wulffern/lelo_temp_sky130a/design/LELO_TEMP_SKY130A/LELOTEMP_CMPR.md

A two-stage OTA used as comparator. Uses a 1U bias current from the bandgap.

It also owns the ramp node housekeeping: an NMOS gated by RST discharges the
integrating node between cycles, and one gated by PWRUP\_N holds it down in
power down.
