wulffern/lelo_temp_sky130a/design/LELO_TEMP_SKY130A/LELOTEMP_CMP.md

A two-stage OTA used as comparator. Uses a 1U bias current from the bandgap
