wulffern/lelo_temp_sky130a/design/LELO_TEMP_SKY130A/LELO_TEMP_routing.png

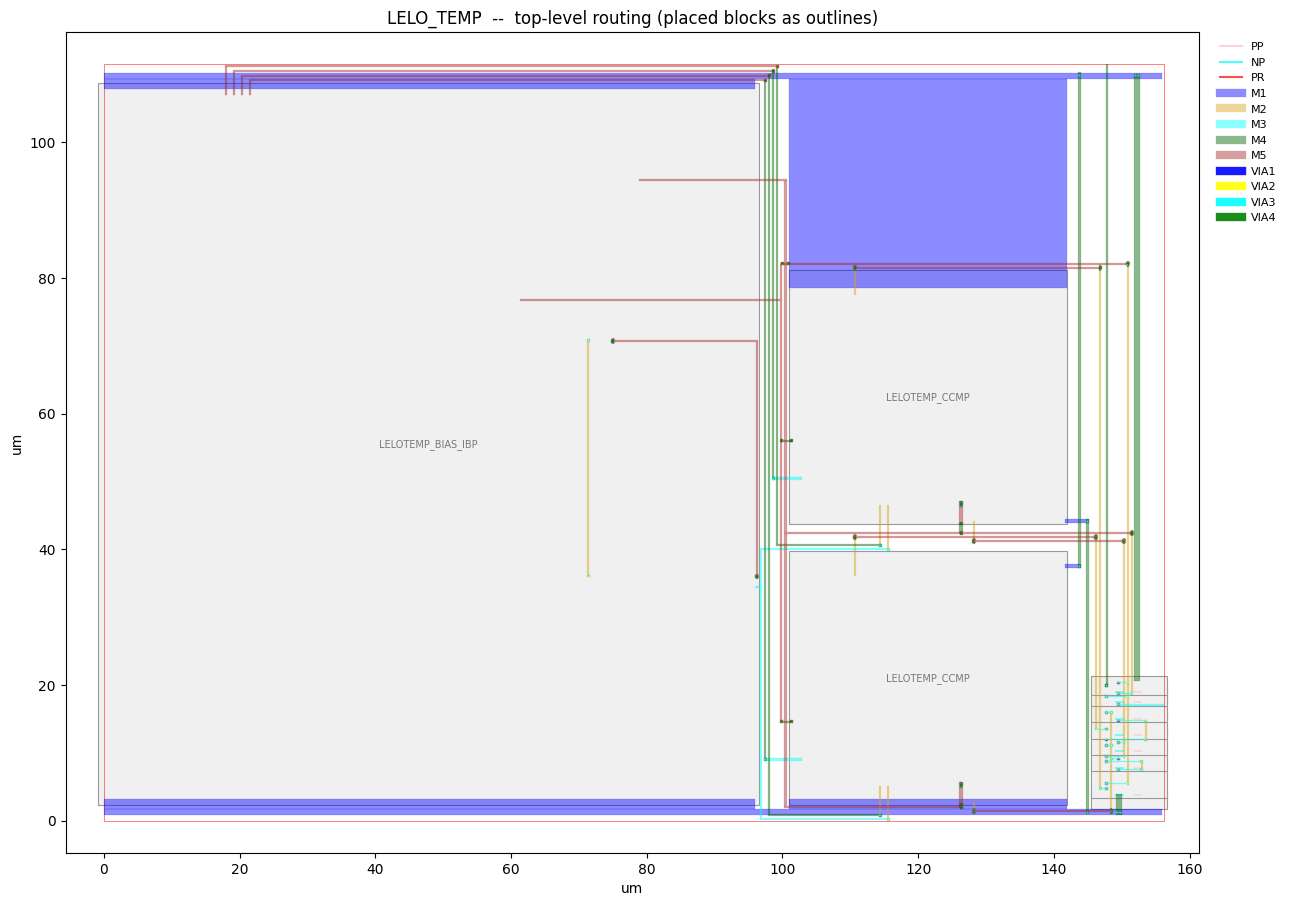
design/LELO_TEMP_SKY130A/LELO_TEMP_routing.png
