wulffern/lelo_temp_sky130a/design/LELO_TEMP_SKY130A/LELO_TEMP.v

//====================================================================
//        Copyright (c) 2025 Carsten Wulff Software, Norway
// ===================================================================
// Created       : wulff at 2025-11-23
// ===================================================================
//  The MIT License (MIT)
//
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
//====================================================================
`timescale 1 ns / 1 ps
`default_nettype none

module LELO_TEMP(
                 input wire  PWRUP_1V8,
                 input wire  VDD_1V8,
                 input wire  VSS,
                 output wire OSC_TEMP_1V8
`ifdef ANA_TYPE_REAL
                 ,input real temperature
`endif
                 );
   //- Define the clock
   logic                     oclk = 0;

   assign OSC_TEMP_1V8 = PWRUP_1V8 &oclk;

   //- Pre-calcualted k/q
   real                      k_q = 8.617333262145179e-05;
   real                      deltaV,id,vd;

   //- Resistance
   real                      rd =  7.535e3*(8+4);
   real                      r_per_K = 36;
   real                      res_temp = rd;

   //- Capacitor to charge
   real                      cap = 53e-15*5 + 19e-15;
   real                      cmp_delay = 1.5e-9;


   //- Delta time for output clock
   real                      dt = 1000;
   real                      to_ns = 1e9;


   real                      ell = 2.35;
   real                      t_kelvin;
   real                      v_bandgap = 1.12;



   //- Generate the output clock
   always begin

      t_kelvin = 273.15 + temperature;
      //- Calculate diode voltage
      //- https://analogicus.com/aic2025/2024/10/25/Diodes.html
      vd = k_q*(t_kelvin)*(ell - 3 *$ln(t_kelvin)) + v_bandgap;

      //- Calculate the delta voltage across the resistance
      deltaV = k_q*(t_kelvin)*$ln(64);

      //Model temperture dependent resistance
      res_temp = rd + r_per_K*(t_kelvin - 300);

      //- Calculate the time to reach the diode voltage
      id = deltaV/res_temp;

      //- dt
      dt = cap*vd/id*to_ns + cmp_delay;

      #(dt) oclk = ~oclk;
   end

endmodule // LELO_TEMP_ANA
