wulffern/lelo_temp_sky130a/(commit log)

2025-11-30 Redesigned, and got chat's help to design the controller correctly. Now the analog is enabled for 1 32kiHz period, while the digital takes a bit longer
    [LELO_TEMP.v, tb.py, tb.v, temp_osc_controller.v]
2025-12-01 added schematic of the oscillator
    [LELOTEMP_BIAS_IBP.sch, LELOTEMP_CMP.sch, LELOTEMP_OTA.sch, LELO_TEMP.sch]
2025-12-11 Added docs
    [LELOTEMP_BIAS_IBP.sch]
2025-12-11 Still trouble at Kff
    [LELO_TEMP.sch]
2025-12-13 Spead up of comparators a bit
    [LELOTEMP_CMP.sch, LELO_TEMP.sch, TB_LELO_TEMP.sch]
2025-12-13 Reduced OTA current a bit
    [LELOTEMP_BIAS_IBP.sch, LELOTEMP_OTA.sch, LELO_TEMP.sch, TB_LELO_TEMP.sch]
2025-12-26 Updated model of verilog to match actual implementation
    [TB_LELO_TEMP.sch]
2026-01-23 testing ntnu github
    [TB_LELO_TEMP.sch]
2026-02-08 duplicate osc ports
    [LELO_TEMP.sch]
2026-02-08 Made NMOS input OTA
    [LELOTEMP_BIAS_IBP.sch, LELOTEMP_OTAN.sch, TB_LELOTEMP_BIAS_IBP_LSTB.sch, TB_LELO_TEMP.sch]
2026-02-08 Fixed NMOS ota (probably
    [LELOTEMP_BIAS_IBP.sch, LELOTEMP_OTAN.sch, TB_LELOTEMP_BIAS_IBP_LSTB.sch]
2026-02-08 Fixed startup
    [LELOTEMP_OTAN.sch, TB_LELO_TEMP.sch]
2026-03-01 tried to make it better
    [LELOTEMP_BIAS_IBP.sch, LELOTEMP_CMP.sch, LELOTEMP_OTAN.sch, LELO_TEMP.sch, TB_LELO_TEMP.sch, res_tempco.sch]
2026-04-05 added layouts
    [LELOTEMP_CMP.sch]
2026-04-05 One step further
    [LELOTEMP_CMP.sch]
2026-04-06 Added layout of comparator
    [LELOTEMP_CMP.sch]
2026-05-02 split up the OTA into multiple blocks to make layout easier
    [LELOTEMP_CASCBIAS.sch, LELOTEMP_CCMP.sch, LELOTEMP_CMP.sch, LELOTEMP_OTACMN.sch, LELOTEMP_OTAN.sch, LELOTEMP_START.sch, TB_LELOTEMP_BIAS_IBP_LSTB.sch]
2026-05-03 Fixed placement for start
    [LELOTEMP_START.py]
2026-05-03 fixed VBN
    [LELOTEMP_START.sch]
2026-05-03 LVS/DRC clean START
    [LELOTEMP_START.sch]
2026-05-03 Started CASCBIAS
    [LELOTEMP_CASCBIAS.sch]
2026-08-04 Drop the accessLayer argument from the pycells
    cicpy removed accessLayer from addOrthogonalConnectivityRoute, so every call
    that still passed it fails with
    TypeError: addOrthogonalConnectivityRoute() got an unexpected keyword
    argument 'accessLayer'
    The cicpy sch2mag test clones this repository and runs LELOTEMP_CMP through it,
    so cicpy CI has been failing on this since the argument went away. Pin geometry
    now comes from the port's own layer and needs no hint.
    Two unrelated adjustments made while getting these cells to route are included:
    LELOTEMP_CMP moves the PWRUP_N_1V8 edge port to "l" with a "-|--" route, and
    LELOTEMP_START widens the VCP ring spacing from 3 to 4.
    Verified with t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
    [LELOTEMP_CCMP.py, LELOTEMP_CMP.py, LELOTEMP_START.py]
2026-08-05 Back to the pmos input OTA, with startup and a packed DRC clean placement
    The bias loop goes back to LELOTEMP_OTA, the pmos input pair. The OTA
    input sits at a diode voltage, 0.45 to 0.8 V over temperature, which the
    nmos input version runs out of at the hot end on 1.8 V. The two symbols
    have identical pins, so the swap is one line of LELOTEMP_BIAS_IBP.
    Startup: two diode connected pmos in series from VDD into VD1. With no
    current VD1 sits near VSS, the stack sees the full supply and injects
    into the diode branch. Once the loop runs VD1 rises, VDD-VD1 falls below
    two gate source drops, and the stack turns itself off. Weakest device in
    the library, JNWATR_PCH_2C5F0, so it loads the loop as l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
    [LELOTEMP_BIAS_IBP.sch, LELOTEMP_OTA.sch]
2026-08-05 Mirror the matched halves and let them abut
    The right half of the input pair and of the matched loads is mirrored
    with the new StackGroup.mirror(), so each pair shares its seam with
    mirror symmetric edge geometry and abuts at zero gap where identical
    columns needed 2 um to stay DRC clean. DRC stays at zero and the cell
    shrinks from 9048x11120 to 8648x11120.
    The regenerated views also pick up the cicpy strap fix: the dummy straps
    now sit on the fillers they cover instead of floating outside the cell,
    which the previously committed mag carried without DRC noticing.
    [LELOTEMP_OTA.py]
2026-08-05 OTA: the ladder short was a power strap, not the stack pitch
    net2..net6 came out shorted to VDD_1V8 with no route attributed, so the
    placement itself looked wrong and the ladder stack had been opened up to
    try to stop the cells merging. That was never it. xbs6 is the only ladder
    device with a VDD source pin, and addPowerConnection straps such a pin
    straight up to the ring: from the bottom of the column that strap ran over
    the source pin of every other ladder device. Stacking the chain the other
    way round, VDD end at the top, makes the strap one cell long. The opened
    pitch is gone with it and the placement is back to abutted.
    With that clear the placement is 0 DRC and 0 shorts, and routing s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
    [LELOTEMP_OTA.py]
2026-08-05 LELOTEMP_OTAR: the OTA on the rey transistors, same device sizes
    Sizes first, since a name for name swap does not preserve them. Every REYATR
    transistor was 12.5% wider than the JNW cell of the same name and no contact
    count landed on the JNW numbers, because the contact pitch itself was 0.36 um
    against 0.32. Fixed in rey_atr rather than worked around here, so NCH_4C5F0,
    PCH_12C5F0, PCH_4C1F2, LVT_PCH_12C5F0 and the RPPO8 unit now match l, w and
    nf exactly. The netlist of OTAR is identical to OTA: same instances, same
    nets, same connectivity, different library.
    Placement is 0 shorts and 0 DRC, but not by copying LELOTEMP_OTA.py wholesale.
    The mirror calls had to go. Mirroring a matched half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
    [LELOTEMP_OTAR.sch]
2026-08-05 OTAR: power through the guard ring, no rail up the column
    Rings on M1, sources tied to their own guard at their own row, one strap per
    column off the body pin out to the ring. M2 upward is now entirely free for
    signals.
    This drops the workaround the strap version needed. REYATR's S and D pins
    overlap in x, so a rail leaving a source ran over its own device's drain, and
    net2 shorted to VDD under every routing option until the VDD strap was pushed
    to the far edge of the pin. A supply that does not travel cannot do that, and
    the alignment argument is gone with it.
    One device is held out: xbs6, the single VDD source in the ladder column,
    whose jog to the guard crosses VCP. 1 short with it in,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
    [LELOTEMP_OTAR.py]
2026-08-06 OTAR: five nets routed, 13 opens down to 8
    Working the plan's loop, one route at a time, keeping what held.
    VIN and VIP first, because every pin of each sits inside its own input
    column: a single vertical run each, neither leaves its stack. Closed
    both.
    VS next, the tail node, which is the source of every input device in
    both columns plus the top of the degeneration resistor down in the
    nmos row. A vertical in each column collapsed eleven components to
    three, and one orthogonal M4/M3 route joined those three across the
    channel and down to the resistor. Closed.
    VD1 and VD2 are the drain pair, each staying in its own lane. They
    close, but they cost: DRC goes from 4 errors to 36, all met2.2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
    [LELOTEMP_OTAR.py]
2026-08-06 OTAR: net1 and PWRUP_1V8 routed, 8 opens down to 6
    Two more nets closed, neither costing a DRC error: net1, the two pins
    between the resistor bottom and the powerdown pull above it, and
    PWRUP_1V8, three gates that all sit in the bias column and need one
    vertical.
    Three that were tried and taken back out, with what they hit:
    VO Its bar reaches from the bias column to the mirror drain
    below, and on every track and side tried, two of each,
    its trunk lands on VIN's in the input column. Shorts
    VD2, VIN and VO together.
    PWRUP_N_1V8 One gate in the bias column, three along the nmos row. A
    horizontal along the nmos row shor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
    [LELOTEMP_OTAR.py]
2026-08-06 OTAR: VCP gets a ring, and the plan's ring section is corrected
    The ring works. My first reading of it did not, and the plan said so
    wrongly, so this replaces that section with what actually holds.
    addRouteConnection was called with an empty includeInstances, which
    gives every pin on the net its own run to the rail, dummy fill included.
    LELOTEMP_START in this same library has always passed the filters and is
    the model. The rail also belongs on the side the pins are already on:
    VCP's groups end at the right of both rows, so the left rail I tried
    first meant crossing the cell.
    The third thing was real: ignoreBoundaryRouting has to be set or the
    ring joins the bounding box and drags the cell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
    [LELOTEMP_OTAR.py]
2026-08-06 OTAR: take the degeneration resistor from rey_tr
    xd2 was REYATR_RPPO8_TOP; it is REYTR_RPPO8 now. Same three pins in the
    same order, P N B, so the swap is the symbol reference and nothing else.
    rey_tr_sky130a joins config.yaml and design/REY_TR_SKY130A is symlinked
    the way the other libraries are.
    0 shorts, 6 opens, 36 DRC, all unchanged across the swap.
    Claude-Session: https://claude.ai/code/session_011UZw6MEnHap4TKj3arkbFP
    [LELOTEMP_OTAR.sch]
2026-08-06 OTAR: VO closed on M2, 6 opens down to 5
    REY_ATR leaves M2 free, which is the layer VO needed. It had failed on
    M3 and M4 because its trunk landed on VIN's in the input column; on M2
    the trunk is clear and only the horizontal had to move, from M3 to M5,
    to clear VD2's channel bar. M2 vertical, M5 horizontal, track6.
    The cost is DRC 36 to 60, all spacing between the new M5 bars and what
    is already in the channel. Four tracks were tried, two of them short,
    and 60 is the floor among the ones that hold.
    0 shorts, 5 opens. Left: VD3, VBP, VCP, PWRUP_N_1V8, and VDD_1V8 at
    xbs6.
    Claude-Session: https://claude.ai/code/session_011U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
    [LELOTEMP_OTAR.py]
2026-08-06 Revert VO: M5 is reserved for power
    The only form of VO that held used M5 for its horizontal, and M5 is the
    power layer. Backed out; VO is open again. 0 shorts, 6 opens, 36 DRC.
    Within M2, M3 and M4 there is no form of VO that both closes and stays
    clean: M3 and M4 put its trunk on VIN's in the input column, M2 clears
    the trunk but then the horizontal has to cross VD2's channel bar and
    only M5 was high enough to do it.
    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
    [LELOTEMP_OTAR.py]
2026-08-07 OTAR: VO crosses in the channel, 6 opens down to 5
    The placement opens an 84 um channel between the rows and nothing ever
    used it: cicpy tracks reports 21 M3 tracks there and 21 free, while
    every horizontal bar in the cell fights the others inside the device
    rows. That is where the evening went.
    afterPlace now registers the gap as a named channel, and each column as
    a vertical one, so routes can aim at them by track index rather than by
    coordinate and the cell still moves between technologies. VO takes
    channel track 5 and column track 8 of the b input lane.
    0 shorts, 5 opens, DRC unchanged at 36. Left: VD3, VBP, VCP,
    PWRUP_N_1V8, VDD_1V8 at xbs6.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
    [LELOTEMP_OTAR.py]
2026-08-07 OTAR: routes torn up, rebuilt from M1 upward
    The old routing put every net on M3/M4 from the start, which left the
    crossing nets and the column local ones fighting for the same two
    layers. It sat at one short, six opens and 51 DRC errors, with each
    guess costing a regeneration.
    Rebuilt in order of reach instead:
    inside one device the cell does it. REYATR now carries a diode
    connected twin tied with one column of M1, and
    cicpy substitutes it from the netlist
    inside one column M1 rails, drain on the right edge of its pin and
    gate on the left, so the two do not share metal
    between columns M2
    across the cell M3/M4,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
    [LELOTEMP_OTAR.py]
2026-08-07 OTAR: 12C is gone from the library, the pmos devices are 11C
    rey_atr's ceiling is 11C now, so the 24 devices that were 12C move.
    Note this changes them electrically: W drops 8%, and it buys nothing
    here. The pmos columns narrow from 8.32 to 8.00 um each but the cell
    does not, because the resistor already set the width --
    pmos row ends 30.24 um
    nmos transistors end 19.76 um
    REYTR_RPPO8 spans 21.76 .. 35.08 um
    Area is 2336 um2 either way, DRC clean, 0 shorts, 12 opens unchanged.
    If the 8% matters for this circuit, the fix is the schematic's device
    count, not the library.
    Claude-Session: https://claude.ai/code/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
    [LELOTEMP_OTAR.sch]
2026-08-07 Added OTAR symbol and fixed IBP instanciation
    [LELOTEMP_BIAS_IBP.sch]
2026-08-07 OTAR: REYTR_RPPO8 is gone, one REYATR_RPPO4 in its place
    A one for one swap so the cell builds, and it is NOT the same
    resistance. The old part was 8 units of l=7.36; the new one is 4 units
    of l=7.2, so R is 49% of what it was. Two RPPO4 in series would be 98%
    and is what this wants, but it needs a second instance and a rewire in
    the schematic rather than a symbol swap, and the space between the
    existing net1 wire and the VDD rail is 50 units where a resistor is 80.
    Area 2848 -> 2195 um2 across today, the last 141 of it from the
    narrower resistor. DRC clean, 0 shorts, 12 opens unchanged.
    Claude-Session: https://claude.ai/code/session_01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
    [LELOTEMP_OTAR.sch]
2026-08-07 OTAR: regenerate on the rebased symbol
    Rebuilt after rebasing onto the new OTAR symbol and the rey library
    link. DRC clean, 0 shorts, 12 opens, all unchanged.
    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
    [LELOTEMP_CASCBIAS.sch]
2026-08-07 Back out the files swept into the previous commit
    A rebase autostash left every pre-existing working tree change staged,
    and the OTAR commit took them with it: CASCBIAS, CCMP, CMP, START, two
    sim READMEs, three plots and .magicrc. None are mine, and all were
    deliberately left uncommitted all session because I cannot attribute
    them.
    Restored to their committed state here. The content is not lost -- it
    is in 6f30848 -- and the working tree keeps it as an uncommitted change
    again, which is where it was.
    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
    [LELOTEMP_CASCBIAS.sch]
2026-08-07 Fixed res in OTAR
    [LELOTEMP_BIAS_IBP.sch, LELOTEMP_OTAR.sch]
2026-08-07 OTAR placement follows your schematic changes
    The bus widths moved and the pycell was matching hard coded ranges:
    xbl1<[0-3]> against a pair that is now 6 a side, xbl0 against a group
    renamed xbl2, xnd1<[0-3]> against loads that are now 3. Devices past
    the range fell into no stack at all -- they still place, just nowhere
    anyone asked. Matching <\d+> instead, so the next width change does
    not need this file.
    Three things the three-deep resistor broke, all measured:
    the column is 48 um tall against an nmos row of 24.8, so the top cell
    climbed out and landed inside the bias column at x 217600 -- every
    rpm.3, rpm.6 and rpm.7 in the cell, DRC 0 -> 111. It has its own
    column right of bot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
    [LELOTEMP_OTAR.py]
2026-08-07 Drop the branch gap between the mirror and the load columns
    n_load_a and n_load_b have always abutted, and their guard rings
    overlap 0.96 um like any two transistor columns. Only n_mirr had
    space=branch_gap, on the strength of a comment claiming an abutted nmos
    boundary violates licon spacing across the seam -- which the other
    boundary in the same row disproves. Measured: abutted, DRC stays clean
    and shorts stay at 0.
    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
    [LELOTEMP_OTAR.py]
2026-08-07 feat(otar): degeneration resistor as a horizontal column in the nmos row
    Replace the two stacked RPPO4 tiles with a column of REYATR_RES_36C2F0
    rows, capped once by addTaps -- the same call the transistor stacks
    already use. The library ships the bare row and the design caps the
    column, so the 4.800 of tap that each framed tile used to pay is paid
    once. Six framed tiles put 55% of the resistor's height into tap.
    Two placement fixes came with it:
    - Abut the NMOS, not the pmos. The column is translated to the nmos row,
    so the pmos is not what it shares a seam with; abutting the pmos left
    the resistor's ring 7.040 um from the nearest guard, a gap dressed up
    as an abutment.
    - No branch_g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
    [LELOTEMP_OTAR.sch]
2026-08-07 fix(otar): two resistor rows, correct wiring, VS/VSS short gone
    The VS/VSS short was not the flush abutment. The swapped-in cell had no
    explicit symbol, so cicpy generated one with all three pins stacked on
    the left edge and every one of them landed on the VS wire:
    xd2<4> VS VS VS REYATR_RES_36C2F0
    B is the guard, so tying it to VS shorted VS to the substrate, and the
    ladder was never wired at all -- which is also why R1 did not appear in
    the netlist and its opens went unreported. Fixed in rey_atr by giving
    the row the cic/res symbol RPPO* already uses. Now:
    xd2<1> VDS R1<0> VSS
    xd2<0> R1<0> VS VSS
    Two rows, not five. The stripes were stretched after the row count was
    picke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
    [LELOTEMP_OTAR.sch]
2026-08-07 feat(otar): route R1<0> and VDS
    R1<0>, the link between the two resistor rows, is a plain vertical now.
    That is what turning the resistor on its side bought: with RPPO4 both
    pins of a link sat near the top of their own guard, so the link had to
    climb the whole height of the upper tile and passed that tile's own P on
    the way -- one component holding R1<0>, R1<1> and VDS, and neither a
    shared regex nor a named lane could separate them. Horizontally the pins
    face each other across the seam, 2.800 apart at the same x with nothing
    between them, so there is no intervening pin to dodge and no lane to
    allocate.
    VDS needed a corner, not a lane: the resistor is in the nmos row at
    x 24.480 and xba1 is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
2026-08-07 feat(otar): route VS, the input pair tail
    VS is the tail node: the sources of xbl1<*> and xbl2<*> plus the
    resistor's bottom, 15 components across two columns. Strapping each
    column on M2 first collapsed it to 3, and one crossing closed it.
    The crossing is on M4, not M3, and that is not arbitrary. VDS already
    crosses the same gap on M3 and the two bars merged into one component
    holding both nets. VS and VDS are the two ends of the same resistor, so
    they cross between the same two rows by construction -- giving them a
    layer each is cheaper than fighting for tracks on one.
    The resistor is now fully wired: R1<0>, VDS and VS all closed. 14 opens
    -> 13, 0 shorts, 0 DRC. What remains are the pre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
    [LELOTEMP_OTAR.py]
2026-08-07 docs(otar): record why VO cannot be routed on any free layer
    VO closes on M4 and M5 and fails on M2, so the net is routable; the
    problem is that there is nowhere left to put it. xba8's drain
    (16.480, 42.700) to xnd4's (8.480, 19.900) crosses the mid channel in
    the same x band as VDS and VS, and all three signal layers are taken
    there:
    M2 closes, 5 DRC -- met1.2 spacing and met1.7 hole area where the
    via drops its M1 landing pads
    M3 shorts to VDS
    M4 closes, shorts to the VS strap in p_in_a
    M5 closes, 8 DRC -- via3.1, the M1..M5 stack is too tall
    Three nets cross the same gap in overlapping x and there are three
    signal layers. Layer-per-net has run out, which is the sa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
    [LELOTEMP_OTAR.py]
2026-08-08 docs(otar): the channel router fixes the bars; the trunks are a cell problem
    Tried addOrthogonalConnectivityRoute with hchannel/htrack for the three
    crossings, per the field guide. It fixes the horizontal half completely
    and shows that the earlier "which layer" question was the wrong one.
    Measured with the tracks tool rather than by drawing and reading the
    short report: a plain route takes its bar height from the net's own
    pins, so VDS's bar sat at y 365000 -- inside the pmos row -- while the
    mid channel held 27 free M3 tracks over the span VO needed and nothing
    had ever been sent there. Given a track each the bars separate cleanly
    (VDS 269000/273000, VS 285000/289000, VO 301000/305000) and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
    [LELOTEMP_OTAR.py]
2026-08-08 feat(otar): route VO with the maze router
    The one net the old router could not place. Every layer either shorted
    or failed DRC, because three nets cross between the rows in overlapping
    x and there are three signal layers -- layer-per-net had run out.
    The search does not have that problem: it is not choosing a layer, it is
    choosing a path, and it knows where the pins are. It goes up M2 out of
    the nmos row, across the MID CHANNEL on M3 at y 340000, and back up M2
    to the pmos pin. That channel held 27 free M3 tracks the whole time and
    nothing had ever been sent there.
    13 opens -> 12, 0 shorts, 0 DRC.
    Claude-Session: https://claude.ai/code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
    [LELOTEMP_OTAR.py]
2026-08-08 revert(otar): stand VO maze route down
    The route was found by a router whose obstacle model was over-strict in
    two ways -- an 8800 via pad where the real cut is 4000, and a via
    treated as claiming every layer rather than the two it connects. With
    both corrected the search finds a shorter path, and that path overlaps
    the VS strap in p_in_a. So the working route was luck wearing the
    clothes of a result.
    Back to 13 opens, 0 shorts, 0 DRC. findroute still reports the path, so
    only the drawing is gone; the pycell records the command.
    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
    [LELOTEMP_OTAR.py]
2026-08-08 feat(otar): publish the eight stacks as their own cells
    Each stack now gets a .mag of its own, LELOTEMP_OTAR_<stack>, with a
    generated subckt, so it can be LVS'd alone. That is the gate the
    hierarchy needs: a stack that fails stops the run where the evidence is
    nine instances rather than 1969 rects.
    LELOTEMP_OTAR_P_SW 9 instances 2 ports (net1..net5 internal)
    LELOTEMP_OTAR_R_DEG 4 instances 3 ports (R1<0> internal)
    LELOTEMP_OTAR_P_BIAS 9 instances 6 ports
    LELOTEMP_OTAR_P_IN_A / P_IN_B / N_LOAD_A / N_LOAD_B / N_MIRR
    P_SW passes DRC standalone. The parent is unchanged -- 0 DRC, 0 shorts,
    13 opens -- because this publishes the stacks rather than restructuring
    the parent to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
    [LELOTEMP_OTAR.py]
2026-08-08 feat(otar): route the ladder in the switch stack's own pycell
    LELOTEMP_OTAR_P_SW.py routes what is internal to that stack: 5 of 5
    ladder nets, 0 blocked, stack DRC clean standalone.
    These are the nets that defeated four attempts at the top level, and
    whole-cell routing could only place three before the last two were
    stranded by the geometry the first three had drawn. They are internal to
    this stack -- nothing above it can see them, collide with them, or needs
    to reserve a track for them -- and scoped to it the search has the room
    whole-cell routing had already spent.
    Each stack now also ships a generated .spice with its fingerprint. The
    parent is unchanged at 0 DRC, 0 shorts, 13 opens: thi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
2026-08-08 feat(otar): generate a schematic per stack, via a stacksch target
    Each stack now has a .sch as well as a .mag, so it can be netlisted and
    LVS'd on its own -- the gate the hierarchy needs.
    Written by the ordinary transpile, not from inside the flow. Two things
    made that necessary and both are recorded in the Makefile:
    - a separate target run AFTER mag, because chaining it re-enters the
    pycell, whose afterPlace wants schematic groups a .cic does not
    carry ("Missing group xbl"), and because the stack cells only exist
    in the .cic once mag has written it.
    - --exclude is NOT optional. transpile writes a schematic for EVERY
    cell in the .cic, LELOTEMP_OTAR included, so without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
    [LELOTEMP_OTAR_N_LOAD_A.sch, LELOTEMP_OTAR_N_LOAD_B.sch, LELOTEMP_OTAR_N_MIRR.sch, LELOTEMP_OTAR_P_BIAS.sch, LELOTEMP_OTAR_P_IN_A.sch, LELOTEMP_OTAR_P_IN_B.sch, LELOTEMP_OTAR_P_SW.sch, LELOTEMP_OTAR_R_DEG.sch]
2026-08-08 chore(otar): regenerate stack cells
    Stack .mag, .sch and .spice after the mazerouter fixes. The parent is
    unchanged at 0 DRC, 0 shorts, 13 opens, and its source schematic is
    untouched.
    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
2026-08-08 chore(otar): regenerate stack cells; drop the hand-written .spice
    The per-stack .spice is gone: the netlist now travels as the cell own
    Subckt and the schematic is written by transpile, so a third
    representation on disk was one to keep in step for nothing.
    Parent unchanged at 0 DRC, 0 shorts, 13 opens.
    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
    [LELOTEMP_CASCBIAS.sch, REYATR_11CWALL.sch, REYATR_CAPTEST.sch, REYATR_CAPX1.sch, REYATR_HRPPO12.sch, REYATR_HRPPO2.sch, REYATR_HRPPO8.sch, REYATR_LVT_NCH_10C5F0.sch]
2026-08-08 docs(otar): record why the diode variants stay on
    Tried without them. The layout is unmoved -- 0 DRC, 0 shorts, 13 opens
    -- but the nets fragment (VD1 3 components to 6, VD2 3 to 5, VD3 6 to 7)
    and those fragments are the missing gate-to-drain ties. The *D cell is
    not an optimisation; it is the only thing making those connections.
    Reverted, with the reasoning in beforePlace so the next person tempted
    by it reads the measurement first.
    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
    [LELOTEMP_OTAR_N_LOAD_A.sch, LELOTEMP_OTAR_N_LOAD_B.sch, LELOTEMP_OTAR_N_MIRR.sch, LELOTEMP_OTAR_P_BIAS.sch, LELOTEMP_OTAR_P_IN_A.sch, LELOTEMP_OTAR_P_IN_B.sch, LELOTEMP_OTAR_P_SW.sch]
2026-08-08 refactor(otar): no signal routing at the top, and r_deg routed by search
    Removed every top-level signal route -- PWRUP_1V8, R1<0>, VDS, the VS
    column straps and its crossing. They were drawn against the whole cell,
    which is the arrangement the levels replace, and they were what stack
    level routing kept colliding with: of 32 routed rects in this cell
    exactly ONE lay inside a stack, so the top routing was almost entirely
    inter-stack and in the way of everything below it.
    Power stays: rings, straps and guard connections are not a search
    problem and are out of scope for the router.
    That costs opens and says so honestly: 13 -> 17, because the four nets
    that used to be routed here are now missin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
    [LELOTEMP_OTAR.py]
2026-08-09 otar: route stacks in beforeRoute, not afterRoute
    A Route added after the routing phase is a Route nobody calls route()
    on. It lands in the cell, logs exactly like a route that worked, and
    draws nothing: the stack level reported '2 routed, 0 blocked' while
    R1<0> stayed open. Moving the call into beforeRoute closes it.
    0 DRC, 0 shorts, 17 -> 16 opens.
    The old VO hook is renamed rather than deleted -- it was a second
    afterRoute shadowing this one, and its reasoning about why that route
    was stood down is worth keeping.
    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
    [LELOTEMP_OTAR.py]
2026-08-09 p_sw: route the ladder with route.py, M1 left aligned on the sources
    The stack pycell called MazeRouter.connect() and emitted rects and cut
    instances itself, and it looked like what it was: a hand stitched wire
    down the middle of the column, one segment at a time, with none of the
    alignment or cut placement route.py gives everything else in the cell.
    Each link in the series chain joins a drain to the source one row below,
    so every one of them is a LEFT route on the pin layer -- trunk left of
    the column, cuts left aligned on the source pins.
    The pin layer comes from TrackMap and not from Rules.get, which returns
    the value once per layer in the technology and hands back 'M1M1M1...'.
    Co-Auth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
2026-08-09 otar: rebuild with stack routing on r_deg
    0 DRC, 0 shorts, 16 opens. R1<0> closes on M1, drawn by route.py.
    The stack cells now carry the wires and vias that were being copied out
    of the parent -- P_SW went from 5 rects to 35 -- and P_SW's schematic is
    regenerated (6 devices where the stale one had 1). That schematic is
    still not a valid netlist: its labels do not touch the symbol pins, so
    every device pin becomes its own net. See HANDOFF_stack_routing.md.
    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
    [LELOTEMP_OTAR_P_SW.sch]
2026-08-09 p_sw: stack the ladder in the direction the devices connect
    Every REYATR device in the column puts S at the bottom and D at the top,
    so a series chain abuts only when the device below offers D to the
    device above offering S. The order was the exact reverse of that.
    Measured with the blockers tool, in the old order:
    net4 pins at y 436000 and 484000 48000 apart
    net3 pin at y 444000 <- between them
    net2 pin at y 476000 <- between them
    Pins are 22400 wide in a column with 16000 of clear space, so there was
    no vertical for net4, or for any other ladder net. Five sessions read
    that as a router bug. It was the placement.
    Read off the netlist the chain is
    VDD -xbs6-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
    [LELOTEMP_OTAR.py]
2026-08-09 otar: route the switch ladder
    STACK_ROUTING gains p_sw. With the chain stacked the right way up and
    cicpy no longer putting the links on the pin layer, the five ladder nets
    close: 0 DRC, 0 shorts, 11 opens, down from 16.
    Magic extracts the series chain the schematic asks for --
    xbs6.D -> xbs1.S -> xbs1.D -> xbs2.S -> ... -> xbs7.D -> xbs8.S
    -- with every device's D and S distinct, which they were not when the
    links were drawn on M1.
    The 11 that remain are group and top level work, not this column:
    VDS VS VO VD1 VD2 VD3 VBP VCP VDD_1V8 PWRUP_1V8 PWRUP_N_1V8.
    Claude-Session: https://claude.ai/code/session_011UZw6MEnHap4TKj3arkbFP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
    [LELOTEMP_OTAR.py]
2026-08-09 p_sw: the stack pycell is live, and routes the ladder itself
    cicpy calls stack pycells between afterPlace and beforeRoute now, so
    this file's route() is finally drawn instead of being queued after
    paint and discarded. Signature is route(layout, entry) -- there is no
    published cell that early.
    Measured against the built-in stack router on the same placement: both
    give 0 DRC, 0 shorts and a correctly extracted series chain, and this
    one does it on the pin layer in 30 fewer shapes because it needs no
    vias. route_stack_level leaves the stack alone now that its pycell has
    spoken.
    LELOTEMP_OTAR: 0 DRC, 0 shorts, 11 opens.
    Claude-Session: htt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
2026-08-09 otar: a schematic per stack, and a switch for boundary routing
    make stacksch produces all eight now that cicpy looks for symbols in
    the library it is writing. The six that were missing are added and the
    two that existed are regenerated: their wires used to sit on a
    placeholder pin grid touching nothing, so xschem connected nothing and
    netgen merged six identical devices into one. They land on the real pin
    rectangles now.
    STACK_BOUNDARY selects whether a stack also routes the nets it shares
    with the rest of the cell -- what it must do once it is a cell rather
    than a region of this one. Left OFF: measured per stack, r_deg, p_in_a
    and p_in_b come out clean and the other five short, all on a ro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
    [LELOTEMP_OTAR_N_LOAD_A.sch, LELOTEMP_OTAR_N_LOAD_B.sch, LELOTEMP_OTAR_N_MIRR.sch, LELOTEMP_OTAR_P_BIAS.sch, LELOTEMP_OTAR_P_IN_A.sch, LELOTEMP_OTAR_P_IN_B.sch, LELOTEMP_OTAR_P_SW.sch, LELOTEMP_OTAR_R_DEG.sch]
2026-08-09 otar: make subcells, then make mag
    Two steps, and the order is the point: every subcell is generated and
    verified before the parent that will hold them is built.
    make subcells CELL=LELOTEMP_OTAR
    make mag CELL=LELOTEMP_OTAR
    Replaces the stacksch target, which was a second transpile carrying a
    negative lookahead over the cell name. cicpy takes the list from the
    subcell plan by name now, and never writes the parent -- checked by
    checksum, not by hope.
    The regenerated subcells gain the ports they were swallowing:
    P_IN_A VD1 VD3 VDD_1V8 VIN VS (VIN was missing)
    P_IN_B VD2 VD3 VDD_1V8 VIP VS (VIP was missing)
    P_BIAS PWRUP_1V8 ... VDS VO (PWRUP_1V8 was mis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
    [LELOTEMP_OTAR_N_LOAD_A.sch, LELOTEMP_OTAR_N_LOAD_B.sch, LELOTEMP_OTAR_N_MIRR.sch, LELOTEMP_OTAR_P_BIAS.sch, LELOTEMP_OTAR_P_IN_A.sch, LELOTEMP_OTAR_P_IN_B.sch, LELOTEMP_OTAR_P_SW.sch, LELOTEMP_OTAR_R_DEG.sch]
2026-08-09 otar: track a .cic per subcell
    make subcells writes one for each, so the MCP route tools can be
    pointed at a single subcell instead of the whole cell. Tracked
    alongside the .mag/.sch/.sym that were already here.
    Each carries the cut cell definitions, without which a via resolves to
    nothing and the checker answers "nothing blocks" for a corridor that is
    not free. The device library is still passed in with --I.
    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
2026-08-09 otar: regenerate the subcells; the schematics have wires again
    The committed subcell schematics were symbol piles: every instance at
    one spot, zero wires, netlisting without complaint. They came from the
    ownership split, where sch2subcells' own printer pass could not see the
    device cells and symbolAndWrite bailed silently on every instance.
    Fixed in cicpy; these are the regenerated artefacts.
    Each subcell schematic now also carries its FILL device, floating
    terminals and bulk on the supply, matching what magic extracts. With
    that, LELOTEMP_OTAR_P_IN_A boundary-routed passes standalone LVS:
    Circuits match uniquely -- the first subcell through the whole gate.
    Shipped state unchanged: STACK_B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
    [LELOTEMP_OTAR_N_LOAD_A.sch, LELOTEMP_OTAR_N_LOAD_B.sch, LELOTEMP_OTAR_N_MIRR.sch, LELOTEMP_OTAR_P_BIAS.sch, LELOTEMP_OTAR_P_IN_A.sch, LELOTEMP_OTAR_P_IN_B.sch, LELOTEMP_OTAR_P_SW.sch, LELOTEMP_OTAR_R_DEG.sch]
2026-08-09 otar: the top routes nothing inside a column any more
    The D-right/G-left column rails leave the top. They were the last
    intra-subcell routing drawn from above, and two authorities wiring the
    same column is how a clean rail and a clean trunk still managed to
    meet. The stack router assigns the same lanes by terminal -- source
    left, drain right, M1 -- and draws them inside each subcell, where
    that subcell's own DRC and LVS stand over them.
    STACK_ROUTING covers five subcells with boundary routing ON:
    r_deg p_sw p_bias p_in_a p_in_b 0 shorts, DRC OK
    n_load_a, n_load_b and n_mirr are out, one mechanism, two severities:
    route.py places a via pad legally on its own pin but cannot yet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
    [LELOTEMP_OTAR.py]
2026-08-09 chore: simulation output leaves the repository
    design/LELO_TEMP_SKY130A/simulation/ -- 25 files, 34M, .raw waveforms
    and .out logs among them -- was swept in by ca2c25c's directory-level
    git add. Untracked, and *.raw, *.out and simulation/ join .gitignore so
    a careless add cannot pull them back.
    The lesson is older than the mistake: stage explicit paths, never a
    directory, in trees that mix sources with build output.
    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
2026-08-09 otar: seven subcells route themselves; ports face the traffic
    STACK_ROUTING covers everything but n_mirr, whose diode-connected VCP
    lives on 3200 gate tabs that no 4000 pad can sit on without a spacing
    error -- blocked with the numbers in the message, not routed wrongly.
    n_load_a and n_load_b rejoin: the trunk-inside-the-pins guard turned
    their pad-overhang shorts into truthful blocks.
    Regenerated subcells carry the distance-graph ports: VD3 exits at the
    bottom of the pmos input columns and the top of the nmos mirror, both
    facing the channel the parent will route across.
    Standalone LVS: R_DEG, P_IN_A, P_IN_B match uniquely. Top: 0 DRC,
    0 shorts, 11 opens.
    sim/ and work/.magicrc modificati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
    [LELOTEMP_OTAR.py]
2026-08-09 otar: 392 device-library copies leave; references go to the source
    Every REYATR .sch and .sym duplicated into this library by ca2c25c's
    directory add is deleted. The canonical files live in
    design/REY_ATR_SKY130A, where the hand-drawn schematic always pointed;
    the generated subcell schematics now point there too (cicpy 47b790b),
    so nothing referenced the copies any more -- verified: subcells
    regenerate, R_DEG, P_IN_A and P_IN_B match uniquely in LVS, top at
    0 DRC, 0 shorts, 11 opens.
    Copies of another library's sources do not merely waste space; they
    drift. A generated stack schematic was wired against the local symbol
    while xschem's own netlisting could resolve either, which is two
    sources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
    [LELOTEMP_OTAR_N_LOAD_A.sch, LELOTEMP_OTAR_N_LOAD_B.sch, LELOTEMP_OTAR_N_MIRR.sch, LELOTEMP_OTAR_P_BIAS.sch, LELOTEMP_OTAR_P_IN_A.sch, LELOTEMP_OTAR_P_IN_B.sch, LELOTEMP_OTAR_P_SW.sch, LELOTEMP_OTAR_R_DEG.sch]
2026-08-09 chore: the repository holds sources, and now says so
    .gitignore learns what this tree generates: docs/ (Jekyll output),
    *.html and the /*_svg/ render directories (cicpy svg), /cdl/ (a stray
    wrong-directory run, deleted), *.vcd, results/ and *_obj_dir/
    (simulation output).
    Eleven .groups.yaml sidecars for OTHER libraries' cells -- JNWATR,
    JNWTR, LELOATR, a cut -- leave tracking: a sidecar belongs beside the
    cell it describes, and these described cells that live in other
    repositories. The LELOTEMP and LELO_TEMP sidecars stay.
    The generated-output piles at the repo root are deleted outright.
    Verified after: subcells regenerate, top at 0 DRC, 0 shorts, 11 opens.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
2026-08-09 otar: 171 lines, a sidecar, and a pycell per subcell
    LELOTEMP_OTAR.py says what the cell IS and nothing else: placement,
    power, and one call into the stack router for every subcell --
    STACK_ROUTING is gone, because what a router cannot take it declines
    by TYPE (n_mirr is declared a mirror in the sidecar, and no mirror
    router exists yet) and a decline is an open, never a short. The
    measurement essays move to cicpy/plans/ and the git log, where they
    were already recorded.
    LELOTEMP_OTAR.yaml declares all eight subcells, match and type; the
    completeness check confirms the regexes claim every instance. Seven
    generated pycell stubs join P_SW's hand-written one, each carrying
    the beforePlace/befor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
    [LELOTEMP_OTAR.py]
2026-08-09 otar: the hierarchical netlist, generated and tracked
    LELOTEMP_OTAR_HIER.spice: eight subckts and a top of eight instances,
    every connection a parent net name. The artefact the next step -- a
    placement flow that places subcells instead of devices -- will build
    from. Subcell artefacts regenerated, unchanged in content.
    Verified: 0 DRC, 0 shorts, 11 opens; R_DEG, P_IN_A, P_IN_B match
    uniquely in LVS.
    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
2026-08-09 otar: all eight subcells pass DRC and standalone LVS
    Placement made the routing possible: p_bias in explicit order so the
    PWRUP_1V8 and VBP gate tabs stop interleaving down the one tab lane,
    and every N stack puts its xns gate device at the BOTTOM so the
    subcell's own tab-lane rail spans the rows above it, leaving the tab
    free for the parent's powerdown via stack.
    Each failing subcell routes what the stack router declines in its own
    pycell, with every trunk derived from LIVE pin rects (pycells run
    before resetOrigins; published coordinates are the wrong frame):
    drain rails right-aligned on their bars, gate rails up the tab lane,
    all on the pin layer with no cuts. p_sw's ladder-bottom source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
    [LELOTEMP_OTAR_P_BIAS.sch]
2026-08-09 otar: hier top gets its supply routing; drain rails right-aligned
    The abutted guard rings do not merge the supplies at extraction
    level, so the hier top ties them by hand: straight bars where pins
    share a y, L's where they do not. The VDD legs land cutless on the
    ring stubs' own metal (a new via next to the ring's mcons cannot
    clear them at any x); the powerdown bar moved up three tracks to
    clear the new VSS leg. DRC clean.
    Subcell drain rails are right-aligned on their bars, the library's
    lane convention.
    Still open at the top: the parent's VBP via stack down to the bias
    gate tab pierces PWRUP_1V8's lane rail (tabs at rows 3 and 2-5-6 of
    one 3200 lane) -- needs xba8 above PWRUP_1V8's span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
2026-08-09 otar: supplies as rings, ports on bulk, no hand-stitched vias
    VDD is a ring on top and VSS a ring on the bottom, each subcell
    reached by stretching its supply port straight through the guard
    column: sch2subcells now places supply ports on the BULK geometry at
    the row boundary (ground lowest, power highest, clipped to the box),
    so the stretch crosses nothing and the pin layer over the stacks
    stays free. Both supplies extract whole; netgen confirms.
    The hand-placed via in p_sw is gone: the L route always cut both
    ends -- the published cell dropped the cut because it landed on the
    guard overhang outside the tight copy box. Copies now include the
    shared-guard margin, flagged as routing so neith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
2026-08-09 otar: every channel net rides a ChannelRoute
    One full-width M3 bar per nmos<->pmos net on its own mid track,
    pins dropped on with addRouteConnection (M2/M4 split at shared
    columns, align left/center/right), each bar trimmed to its
    outermost drop. Replaces the orthogonal combs and their trunks:
    1126 routed shapes down to 447, DRC clean.
    Known remaining: the PWRUP_N load-side drop lands on a duplicate
    subport rect at the wrong row and grazes the VBP bar, merging the
    powerdown family; plus the pre-existing bias-lane stack pierce.
    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
2026-08-09 otar: supply ports on true bulks, drops on ports, resistor drops left
    The N-row VSS ports sat on source straps; the supply-port pick now
    prefers BULK rects (the guard/tap column) so the ring connection is
    genuinely through B. addRouteConnection drops one vertical per
    instance, on the instance's PORT for the net -- the access-rect list
    carries duplicate subports and one stale-positioned duplicate
    dropped a via stack into a foreign bar. The resistor's VDS and VS
    drops align left, off the serpentine's center.
    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
2026-08-09 otar: bias lane de-interleaved; top is DRC clean, 0 shorts, 0 opens
    p_bias order (xba1,xba8,xba2,xba6,xba7,xba3): the VBP gate tab sits
    below every PWRUP_1V8 tab, VO's and VBP's drains both stay adjacent.
    xba8's gate joins its drain pair on an M4 L whose far cut now lands
    under the wire. At the top the two bias-lane drops split by layer
    (VBP M4, PWRUP_N M2) and the VBP drop lands cutless on the subcell's
    own M4 pad. All 8 subcells DRC+LVS clean; the top extracts every
    net whole and separate -- remaining LVS delta is pin-label level
    (VO/PWRUP_1V8 swap, VSS vs substrate matching).
    Claude-Session: https://claude.ai/code/session_011UZw6MEnH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
    [LELOTEMP_OTAR.py]
2026-08-09 otar: LELOTEMP_OTAR is DRC and LVS clean
    The hierarchical layout IS the cell now: LELOTEMP_OTAR.mag carries
    the eight-subcell top with its ChannelRoute channel and ring
    supplies, and `make gds cdl lvs CELL=LELOTEMP_OTAR` answers
    "Circuits match uniquely". The schematic gains the two fill
    transistors the layout has always had -- a schematic carries fills
    so LVS can match the physical cell; the placement flow now skips
    xfill_* devices from the netlist so they are not placed twice.
    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
    [LELOTEMP_OTAR.sch]
2026-08-09 otar: make hier writes LELOTEMP_OTAR directly
    The hier target places the generated hierarchical netlist with the
    <CELL>_HIER hooks and publishes the result as <CELL> itself -- the
    scaffold name stays out of the artifacts. make hier, make drc,
    make gds cdl lvs all run on LELOTEMP_OTAR and answer DRC OK and
    "Circuits match uniquely".
    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
2026-08-09 otar: the sidecar is the whole truth; LELOTEMP_OTAR.py retires
    The yaml now declares membership, placement order, floorplan rows,
    channels and supplies -- including the two measured orderings (xns
    at each N stack's bottom; the de-interleaved p_bias) with their
    reasons. cicpy's sidecar recipe executes it; the 171-line pycell is
    gone. All eight subcells and the assembled top verify unchanged:
    DRC OK, "Circuits match uniquely".
    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
2026-08-09 otar: one sidecar, no python
    LELOTEMP_OTAR.py and LELOTEMP_OTAR_HIER.py are gone: the yaml holds
    membership, placement order, floorplan rows, channels, supplies and
    the hier route table -- drops discovered, overrides only where the
    bias column's shared centerX forces a layer or an align. Both flows
    verify: all eight subcells and the assembled LELOTEMP_OTAR are
    DRC OK and "Circuits match uniquely".
    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
2026-08-09 Fixed symbol for OTAR
    [LELOTEMP_OTAR.sch]
2026-08-09 otar: fill instances follow the naming convention; two-cut vias
    The two schematic fill transistors were named Xxfill_* -- the only
    uppercase instance names in the schematic -- so the netlist name
    xxfill_* slipped past every xfill_ check, became two subcells of
    their own and landed at the origin, on top of the N row. Renamed to
    xfill_* like everything else; the accidental XXFILL pycells go with
    it. All layout regenerated with cicpy's two-cut vias and
    align-following drops: eight subcells and the top all DRC OK and
    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
    [LELOTEMP_OTAR.sch]
2026-08-09 otar: phase-margin resize, supply-shorted dummies, no coordinates
    The schematic change: 4 load devices per side (was 3) and 4 input
    devices (was 6). Dummies follow the new policy -- PMOS fills shorted
    to VDD_1V8, NMOS to VSS, in schematic and layout both; the schematic
    carries one fill per class (two LVT 11C5F0 on VDD for the input
    pairs, one NCH 4C5F0 on VSS for the mirror).
    Every stack pycell now states its rails from the pins -- trunkright /
    trunktab -- instead of trunkx coordinates, and survives exactly this
    kind of resize. p_sw's ladder went back to the stack router.
    All eight subcells and the top: DRC OK, "Circuits match uniquely".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
    [LELOTEMP_OTAR.sch, LELOTEMP_OTAR_N_LOAD_A.sch, LELOTEMP_OTAR_N_LOAD_B.sch, LELOTEMP_OTAR_N_MIRR.sch, LELOTEMP_OTAR_P_BIAS.sch, LELOTEMP_OTAR_P_IN_A.sch, LELOTEMP_OTAR_P_IN_B.sch, LELOTEMP_OTAR_P_SW.sch]
2026-08-10 refactor: LELOTEMP_OTAR sidecar is one python file
    The yaml sidecar and the eight per-subcell hook files fold into
    LELOTEMP_OTAR.py: subcells as classes, hooks inline on them, rows and
    hier drops referencing the classes. Same declarations, executed by the
    same cicpy recipes; rebuilt and re-verified DRC OK and LVS 'Circuits
    match uniquely' on the top and standalone subcells.
    Claude-Session: https://claude.ai/code/session_01V2NXKz4pJqzwkkQt9GQ19N
2026-08-10 refactor: LELOTEMP_OTAR as one SidecarCell class
    The cell is a class, the subcells are nested classes on it, and the
    hooks are methods whose self is the placed group. The assembled
    top's channel/routes sit on the cell class itself. Re-verified DRC
    OK and LVS 'Circuits match uniquely' on the top and standalone
    subcells.
    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
2026-08-10 chore: regenerate under current toolchain; BIAS_IBP schematic and sims
    Rebuilt artifacts (port class signal->power on supply-ish nets, cut
    cells, OTAR .cic/.mag) verified deterministic: subcells+hier rebuild
    byte-identical, DRC OK, LVS Final result: Circuits match uniquely.
    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
    [LELOTEMP_BIAS_IBP.sch, TB_LELO_TEMP.sch]
2026-08-10 feat: LELOTEMP_BIAS_IBP layout -- sidecar, all 11 subcells DRC+LVS clean
    One declarative sidecar builds the bias block: the pmos source
    ladder (gate LPI) beside the cascode ladder (gate VCP) in matched
    order so every source-cascode net crosses the seam at its own row,
    the 6-segment poly ladder, the bipolar core and the OTA placed as
    the finished cells they are, startup, a decap column with the dummy
    supply treatment, and the MiM caps as columns with plate rails on
    their true layers (cicpy M4/M5 = magic metal3/metal4).
    The hand schematic carries the layout's fill population (11x 2C5F0,
    8x 4C5F0, all supply-tied) so the top netlists agree.
    Every subcell verifies standalone: DRC OK and LVS "C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
    [LELOTEMP_BIAS_IBP.sch, LELOTEMP_BIAS_IBP_BIP.sch, LELOTEMP_BIAS_IBP_CAP_LPI_A.sch, LELOTEMP_BIAS_IBP_CAP_LPI_B.sch, LELOTEMP_BIAS_IBP_CAP_VCP.sch, LELOTEMP_BIAS_IBP_N_G.sch, LELOTEMP_BIAS_IBP_OTA.sch, LELOTEMP_BIAS_IBP_P_CAS.sch]
2026-08-10 feat: LELOTEMP_BIAS_IBP assembled top -- DRC 4, LVS Circuits match uniquely
    The assembled bias block passes LVS ("Final result: Circuits match
    uniquely") with 4 remaining DRC slivers (two seam-hop cut pads
    grazing cell-internal met1/mcon by <0.05um).
    What it took, all measured:
    - seam hops are L-shapes ("-|--") on M4: a D pin and an S pin sit
    0.8um apart in height WITHIN the cell, and a straight wire put the
    far cut just off the far pin;
    - xca4/xca2 moved to the BOTTOM of their ladders so VR1's channel
    drop stays below the IBP rows, and VD1 enters p_cas by a seam hop
    from p_su with its discovered drop skipped -- a drop's via column
    clips every other net's pin stack in the drain wi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
    [LELOTEMP_BIAS_IBP.py]
2026-08-10 chore: drop stale XSTACK publications; refresh assembly over re-published OTAR
    The XSTACK_* files were leftovers of the first publication run, from
    before the tap instances were claimed into their stacks' match
    regexes. The top and OTA wrapper re-generated over the OTAR that was
    re-published under the corrected VIA4 rule; full flow re-verified:
    DRC 4 known slivers, LVS "Circuits match uniquely".
    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
    [LELOTEMP_BIAS_IBP_XSTACK_N_G_BOT.sch, LELOTEMP_BIAS_IBP_XSTACK_N_G_TOP.sch, LELOTEMP_BIAS_IBP_XSTACK_P_CAS_BOT.sch, LELOTEMP_BIAS_IBP_XSTACK_P_CAS_TOP.sch, LELOTEMP_BIAS_IBP_XSTACK_P_CC_BOT.sch, LELOTEMP_BIAS_IBP_XSTACK_P_CC_TOP.sch, LELOTEMP_BIAS_IBP_XSTACK_P_SRC_BOT.sch, LELOTEMP_BIAS_IBP_XSTACK_P_SRC_TOP.sch]
2026-08-10 feat: route plans for OTAR and BIAS_IBP; cic files carry only placed cuts
    The .routes.yaml files are the maze router's captured conclusions
    (cicpy route plan): rebuilds replay them and the subcells build
    drops from 74 s to 0.7 s. The published .cic files shrink by the
    speculative cut definitions the search used to register without
    placing; every placed cut is still embedded. Full flow re-verified:
    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
2026-08-10 feat: wires in the sidecars; LELOTEMP_CCMP DRC OK, LVS match
    The maze router's conclusions now live in the sidecars as `wires`
    declarations (pasted from the builds' .routes.py) and rebuilds
    replay them: OTAR and BIAS_IBP subcells in half a second. The
    .routes.yaml side-files are gone; *.routes.py is scratch output,
    ignored.
    LELOTEMP_CCMP converted from the classic pycell to the declarative
    sidecar and driven clean -- from 61 DRC errors and a failed LVS to
    DRC OK and "Circuits match uniquely". What it took, measured:
    - the JNWTR cap's plates are cicpy M4/M5 (magic m3/m4); the old M5
    rail put its pads into the VSS plates. plateRail on the true
    layers, starting OVER the first mimcap -- a r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
    [LELOTEMP_BIAS_IBP.py, LELOTEMP_CCMP.py, LELOTEMP_OTAR.py]
2026-08-10 feat: LELO_TEMP top placed in a TinyTapeout 1x1 tile; blocks pinned at edges
    The top-level assembly fits tt_block_1x1_pg.def: 155.9 x 109.5 um of
    content in the 161 x 111.52 tile. The bias block gave up its channel
    headroom (12 -> 6 um, re-verified) to clear the height; the sidecar
    packs the L that rows cannot say -- bias left, the two comparators
    stacked to its right (afterPlace + updateBoundingRect refresh, or
    the ring wraps the stale scatter), the logic strip at the far right.
    Every buried block pin now lives at an edge for the parent to reach:
    - BIAS: VD1(=VC) and LPI bars keep their right end at the cell edge
    (the new route `trim` key), the four IBP_1U verticals their tops;
    the pow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
2026-08-11 feat: LELO_TEMP top-level routing; every block net connects
    The top routed as one VSS blob, and the cause was never the routes.
    - addPowerConnection stretches EVERY published supply rect to the
    ring, tap bars included, and each stretched copy slices through
    the core it came from. Dropped; each block ties its own edge bar.
    - addRouteRing wraps the layout bbox, which does not count the
    physical-only tapcell, so the bottom ring landed 2 um inside the
    content and its 9 um li bar shorted the logic strip's AVDD to
    AVSS. Rings now sit on an explicit rect spanning every instance.
    - ring attachments moved to beforePaint: the rings re-lay as routes
    grow the bbox, and a c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
    [LELO_TEMP.sch]
2026-08-11 fix: DRC 238 -> 93; the lane plan gets the spacing the rules ask for
    The topology was settled, the geometry was not. What the rules
    actually wanted, once measured rather than assumed:
    - a long M4/M5 run is "large metal" and asks 0.4 um of its
    neighbours (met4.5a/b), not the 0.3 um of met4.2, so parallel
    lanes need a 7 um pitch, not 6
    - a via stack's pad on a layer it only passes through is 0.44 um
    square = 0.19 um^2, under the 0.24 that met3.6/met4.4a want. The
    patch is 0.3 x 0.85 um, NOT a 0.5 um square -- the square is
    wider than the lanes and eats the spacing on both sides
    - the M2-M3 cut pad is 4.4 um, wider than a 3 um column, so the
    columns over the logic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
    [LELO_TEMP.py]
2026-08-11 docs: bring the README, the agent notes and the plans up to the layout
    The README still described the bias block as unrouted, with a list of
    open nets, from before it closed. Replaced with what is actually there:
    the top level placed and routed into the TinyTapeout tile, a figure of
    it and a figure of the top-level wires alone, the per-block DRC/LVS
    state, and how the routing works.
    The agent notes had nothing about integrating finished blocks, which is
    where this went wrong for a long time. AGENTS.md and CLAUDE.md now
    carry the rules that only appear at that level -- do not call
    addPowerConnection, addRouteRing cannot see physical-only instances,
    attach to rings in beforePaint, route over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
2026-08-11 docs: publish the layout flow, and keep the agent guidance in one file
    The Jekyll site is built by jnw-actions/doc/gendoc, which writes a
    fixed set of pages and copies documents/ in on top; the DOCS workflow
    triggers on documents/**. So the layout flow is published as
    documents/layout_flow.md, committed rather than built in CI, and a
    make rule regenerates it from LAYOUT_FLOW.md so the two cannot drift.
    LAYOUT_FLOW.md stays the one source.
    AGENTS.md and CLAUDE.md had grown two copies of the same guidance --
    both carried the top-level integration rules after the last commit,
    and both carried routing rules. That is exactly the thing that drifts.
    AGENTS.md is now the single file: it gains the c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
2026-08-11 refactor: LELOTEMP_BIAS_IBP, 434 -> 342 lines of the same layout
    Four kinds of duplication, none of them load-bearing:
    - `_rail()` was a line-for-line copy of StackGroup.plateRail, log
    strings included. LELOTEMP_CCMP already calls the library method;
    this file carried its own. Deleted.
    - four `wires` blocks that can never be read. p_cc, cap_lpi_a,
    cap_lpi_b and cap_vcp all return True from beforeRoute, and
    route_stack_level continues at mazerouter.py:1249, before
    wires_lookup at :1328. Dead on arrival.
    - the same five-line ROUTER-GENERATED banner nine times, 45 lines
    saying one thing. Now one note above the class -- and it states
    the rule that made those fo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
2026-08-11 build: one command per cell -- LELOTEMP_OTAR says it is hierarchical
    `make mag CELL=<anything>` is now the whole story: cicpy reads
    <CELL>.py and picks the flow, so nothing outside the design has to
    remember which cell needs two passes.
    LELOTEMP_OTAR needed them and never said so. It has the subcells and
    the _HIER netlist, but no `hier_cell`, so the unified command built it
    flat -- which succeeds and then fails LVS. It declares
    `hier_cell = HierLayoutCell` now and comes back "Circuits match
    uniquely".
    SUBCELL=<name> passes through to the new --subcell, for working on one
    subcell without regenerating the rest.
    Claude-Session: https://cl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
    [LELOTEMP_OTAR.py]
2026-08-11 fix: LELOTEMP_BIAS_IBP DRC 18 -> 6; the powerdown nets are rings
    The two powerdown nets were forty-five lines of hand-placed rects,
    cuts, an li cover, a min-area pad and an updatePort, all of it
    re-deriving what a route ring already knows. They are two
    declarations now, in the cell's own beforeRoute beside the supplies:
    layout.addRouteRing("M5", net, "t", widthmult=2, spacemult=2)
    layout.addRouteConnection(f"^{net}$", "^xota$", "M5", "top", "")
    The hand-drawn geometry WAS three of the DRC sites -- a met3.2, a
    via2 and an li abut/overlap -- so they went with it.
    The seam nets stay in BiasHier.route(). They cannot move to
    beforeRoute: the access rects addConnectivityRoute matches on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
    [LELOTEMP_BIAS_IBP.py]
2026-08-11 fix: put back LELOTEMP_BIAS_IBP's powerdown exposure, which I deleted
    85a80e4 replaced forty-five lines of hand-drawn powerdown geometry
    with two route-ring declarations in the cell's beforeRoute, and
    reported DRC 18 -> 6. The rings were never drawn. The assembly pass
    loads NO pycell -- import_beside looks for <CELL>_HIER.py, there is
    none, and cic.py deliberately does not write a template there because
    that would shadow the sidecar -- so a hook on the SidecarCell class
    never runs. Only HierLayoutCell's own place() and route() do.
    So the 6 was geometry deleted, not geometry replaced. The measurable
    damage: PWRUP_1V8 and PWRUP_N_1V8 came out as INTERIOR pins, locali at
    y 17140 and metal2 at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
    [LELOTEMP_BIAS_IBP.py]
2026-08-11 feat: put OTAR's inputs on the bottom edge, now that afterPorts runs
    The hook was always there in spirit: VIN and VIP are the p_in gate
    tabs, and a subcell's tabs sit mid-cell, so the published pins sat
    ~10 um up inside a cell 13.7 um tall and anything reaching them drove
    a trunk deep past the internals. That is where LELOTEMP_BIAS_IBP's
    two met1.2 sites came from. The assembly pass loaded no pycell, so an
    afterPorts on the cell class could not move them; cicpy e8b7053 makes
    the sidecar class the layout cell, and it can.
    offset_track+1, not a plain drop: straight down, the vertical runs
    0.04 um from the VD1 channel drop's elbow and met1.2 wants 0.14.
    One track right clears it, measured -- O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
2026-08-11 wires: regenerate the fingerprints for the relative stack_key
    cicpy 714ee8e makes stack_key hash each member's position relative to
    the stack's own corner instead of absolutely, so all eleven wires_key
    strings change. Replay hits again; without this every block searches
    afresh on every build.
    Also finishes a comment-out in LELOTEMP_BIAS_IBP.py that had been left
    half done: line 270's addConnectivityRoute( was commented but its
    continuation was not, so the module did not parse, the sidecar failed
    to import, and the cell had been building WITHOUT it -- DRC 8 -> 5 and
    LVS failing, which looks like a design regression and is not one. With
    it parsing again the cell is back to DRC 8, Circuits mat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
    [LELOTEMP_BIAS_IBP.py, LELOTEMP_OTAR.py]
2026-08-11 n_load_a: VD1 as two stories, 119.6 um of wire down to 33.6
    Same decomposition as before -- one rail for the drain bars, one for
    the gate tabs, both on M1, the devices' own metal joining them -- said
    as two scoped paths instead of two addConnectivityRoute calls:
    bars = layout.path("VD1", "M1", includeInstances=...)
    bars.trunk(bars.right_of_pins())
    tabs = layout.path("VD1", "M1", includeInstances=...)
    tabs.trunk(tabs.tab_lane())
    make gds cdl lvs: DRC 0, Final result: Circuits match uniquely. Not
    byte identical to what it replaces and not meant to be: `||` draws a
    trunk AND a landing pad per pin, because it must work when the pins
    are not already under the trunk. Here they ar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
    [LELOTEMP_OTAR.py]
2026-08-11 layout: regenerate every artefact against the sources now committed
    All five prototype cells rebuilt and checked with `make gds cdl lvs`,
    which is the only invocation that means anything -- lvs on its own
    reads whatever was last extracted:
    LELOTEMP_CMP DRC 0 Circuits match uniquely
    LELOTEMP_CCMP DRC 0 Circuits match uniquely
    LELOTEMP_OTAR DRC 0 Circuits match uniquely
    LELOTEMP_BIAS_IBP DRC 8 Circuits match uniquely
    LELO_TEMP DRC 95 Netlists do not match (the known VR1
    label artefact, unchanged)
    What actually moved:
    LELOTEMP_OTAR_N_LOAD_A VD1 as two scoped path trunks (c34e0e9);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
    [LELOTEMP_BIAS_IBP.sch]
2026-08-11 hier: one command builds the whole cell, subcells and all
    `make mag` is the only command again. OTAR and BIAS_IBP declare
    `routes`, so cicpy splits their netlists, builds a cell per subcell and
    assembles them in one pass -- `make subcells hier` and the generated
    <CELL>_HIER.spice are gone, and so is asking `self.assembled` which
    pass we are in, because there is only one.
    The `trunkx` values in the wires blocks are rebased: they were resolved
    in the flat parent's frame and a subcell is now its own frame. Verified
    by measuring that every one of the 20 subcells is a PURE TRANSLATION of
    its flat placement, instance by instance, so the rebase is exact.
    Three BIAS_IBP blocks (r_lad, p_src, p_cas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
    [LELOTEMP_BIAS_IBP.py, LELOTEMP_OTAR.py]
2026-08-11 routes: one track per net, because a track is one legal lane now
    Every `track:` halves: cicpy spaces channel tracks by width + space
    instead of by the finer search grid, so consecutive indices are
    consecutive lanes and the "two apart" rule disappears from the comments
    because it disappeared from the arithmetic.
    DRC and LVS unchanged: OTAR 0/match, BIAS_IBP 8/match.
    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
2026-08-11 bias: the powerdown pins are two lines now
    promoteInstancePort replaces the hand-drawn riser, cut, pad and edge
    pin -- and with it the last typed geometry in this design file. 8 DRC
    and "Circuits match uniquely", both unchanged.
    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
    [LELOTEMP_BIAS_IBP.py]
2026-08-11 routes: say two cuts, which is what was being drawn
    The `cuts` argument never reached route.py, so these numbers were
    comments and the 2x1 default decided. They say 2 now, which is what the
    geometry already was -- DRC, LVS and cost unchanged on both cells.
    p_bias's PWRUP_1V8 keeps its 1, said twice and meant: a 2x1 pad does
    not fit beside the guard ring there.
    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
    [LELOTEMP_BIAS_IBP.py, LELOTEMP_OTAR.py]
2026-08-11 wires: anchors, not coordinates
    Every trunkx in both sidecars becomes the anchor the pins produce:
    trunktab, trunkright, trunkleft. Ten were exactly the anchor already;
    the rest are the same lane within half a wire width, which is the rule
    the router itself now applies.
    Nothing moves: DRC, LVS and cost identical (OTAR 0/match/492.30,
    BIAS_IBP 8/match/765.02). What changes is that these blocks can no
    longer go stale -- an anchor is recomputed from the net's own pins on
    every run -- and they say why the wire is there.
    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
2026-08-12 otar: n_load_a and n_load_b need no beforeRoute
    Both hooks existed for one reason -- VD1 and VD2 mix wide drain bars
    with narrow gate tabs, and no single vertical lands on both shapes.
    cicpy splits such a net onto a rail per shape now and derives the same
    two scoped routes the hooks spelled out, so the hooks are gone.
    0 DRC and "Circuits match uniquely", unchanged.
    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
2026-08-12 fix: meet the OTA's powerdown pins on M2, not M1
    LELOTEMP_OTAR_P_BIAS already puts a via on those pins and carries the
    net to M2. Promoting them from M1 stacked a second via beside the
    first, 0.04 um off -- two contacts of one type half over each other,
    which magic reports as "This layer can't abut or partially overlap
    between subcells" and which was the last of this cell's 8 DRC errors.
    startLayer="M2" is the same thought as the endStopLayerM2 on the VD1
    route a few lines above: meet the pin on the metal it has been brought
    up to.
    0 DRC, LVS "Circuits match uniquely", one via and one pad fewer.
    Claude-Session: https://claude.ai/code/s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
    [LELOTEMP_BIAS_IBP.py]
2026-08-12 refactor: stopLayer is the name for it, and say why
    promoteInstancePort's argument was startLayer for a day. What it does
    is exactly what stopLayer means in Cut.getCutsForRects and in a route's
    endStopLayerM2 -- which this file uses twenty lines above -- so it is
    called stopLayer now, with a comment saying what it is for.
    No geometry change: 0 DRC, LVS "Circuits match uniquely".
    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
2026-08-12 fix: drop the blocks 0.13 um so the S band clears met4.5
    The four M5 lanes over the bias block need 0.40 under the first one
    (met4.5a/b, "attached to large metal4"), 0.30 x 4 of wire, 0.40 x 3 of
    gap and 0.09 for the via cap above S(4) -- 2.89 um. Between the block's
    top and the 111.52 um tile ceiling there was 2.76. Everything in the
    strip is already at its minimum, so the room had to come from below.
    It is there. The rings are laid on the instances' own bbox, so they
    come down with the blocks and the band beneath them absorbs the move:
    the cell goes 111.500 -> 111.370 on the move alone, 87 DRC -> 82. With
    S at +4000 it lands on 111.520 exactly -- the tile budget, to the
    nanometre -- and 7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
    [LELO_TEMP.py]
2026-08-12 feat: the powerdown pins leave BIAS_IBP eastward, not north
    Carsten's idea: let the nets escape the subcell differently instead of
    fighting the band they were escaping into.
    Everything that consumes PWRUP_1V8 and PWRUP_N_1V8 -- both comparators
    and the whole logic strip -- is EAST of this block. Promoted to the top
    edge they came out mid-block at y 103.4, went back down 30 um, and then
    had to cross the bias-ccmp lane band to get where they were going. That
    band is eight lanes at a 0.6 um pitch and cannot legally hold an M4-M5
    via at all: the pad is 0.54 um and wants 0.30 either side, so 1.14 is
    needed and 0.60 exists. Every crossing was an illegal hop, and the two
    nets accounted for 29 of L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
2026-08-12 feat: AUTOROUTE=1 -- hand LELO_TEMP's top nets to the maze router
    Carsten asked to try the router again. One addConnectivityRoute per net
    in the node graph, no guidance of any kind, hand-drawn PORT pins kept
    (they are the cell's interface, not routing, and dropping them fails
    LVS for reasons that say nothing about the router).
    lane plan (778 lines) router
    DRC 72 66
    shorts 13 6
    opens 13 8
    time - 3.3 s
    Neither passes LVS: the hand build gives "Netlists do not match", the
    router's "Top level cell failed pin matching", and matchport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
    [LELO_TEMP.py]
2026-08-12 fix: correct the AUTOROUTE claim -- the router loses, not wins
    The previous commit said the router beat the lane plan. It does not,
    and the error was counting short COMPONENTS instead of nets. One
    component can hold thirty nets, so a build that merges everything
    scores well on a count of components.
    shorts nets shorted worst
    lane plan (778 ln) 13 24 8 nets
    router, all on M5 6 29 24 nets
    router, M3/M4/M5 4 32 29 nets
    router, M4/M5 only 5 37 33 nets
    Every variant collapses into one giant component. The bridges say why:
    the top level has no idea which layers the BLOCKS own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
    [LELO_TEMP.py]
2026-08-12 refactor: name the bands, and tell VC as a story
    The first step of the conversion, and the shape the rest will take.
    afterPlace registers the five corridors this floorplan opens -- lband,
    dband, bband, myband, sband -- so a route can aim at "lband track 1"
    instead of a lambda over a literal pitch. A track index survives a
    resize and another technology; 960000 + 1000 + (i-1)*6000 does not.
    VC then becomes two `~` stories, one per target. Six wire()/stk() calls
    over literal lanes became six anchored steps, and not one coordinate is
    left in them.
    Behaviour-neutral, which is the point: 72 DRC, 13 shorts, 13 opens --
    identical to the hand version -- and 13 fewer rects.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
    [LELO_TEMP.py]
2026-08-12 refactor: tell LPI as a story
    Up out of the OTA pad, east to the L band's first lane, down it to the
    bar's own row, and in on M3 -- which is the bar's own layer, so the
    last leg IS the bar. Five wire()/stk() calls with literal offsets
    become eight anchored steps and no coordinates.
    DRC 72 -> 68, nets caught in a short 24 -> 24,
    worst component 8 nets -> 6
    The 8-net blob split: LPI no longer joins PWRUP_1V8 and PWRUP_B_1V8 to
    the VCP/VIP/VR1/VS group. Component count goes 13 -> 14 and that is the
    metric being right, not a regression -- one blob became two smaller
    ones.
    Claude-Session: https://claude.ai/code/session_01V2NXKz4pJq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
    [LELO_TEMP.py]
2026-08-12 refactor: logic_story, and RST_B told with it
    The strip fan-out as `~` stories rather than a helper holding a column
    coordinate: one story per (source, logic pin), out of the source, up to
    M5, across a named band, down the net's own column, in on M3 at the
    pin's own row. The columns are TRACK INDICES in the dig channel now, so
    a column is "the strip's fourth lane" and not DIG_X1 + 23500.
    RST_B is the first net on it, and the lane was chosen by measuring:
    track 3 -> 66 DRC, 4 -> 70, 5 -> 68, 6 -> 73. That is what a track
    index buys -- the choice is a small integer to sweep, not a literal to
    re-derive.
    DRC 68 -> 66, nets caught in a short 24, worst 6 -- unchanged
    shapes 4137 -> 4085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
    [LELO_TEMP.py]
2026-08-12 refactor: RST_A told with logic_story
    Same shape as RST_B, crossing on the my band instead of the b band.
    Lane swept: track 6 -> 64 DRC, 7 -> 64, 8 -> 66.
    DRC 66 -> 64, connectivity unchanged (24 nets shorted, worst 6)
    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
    [LELO_TEMP.py]
2026-08-12 refactor: both comparator outputs told with logic_story
    CMPO_A crosses on the my band, CMPO_B on the s band, each down its own
    column over the strip.
    DRC 64 -> 54, opens 13 -> 11, worst component 6,
    nets caught in a short 24 (unchanged)
    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
    [LELO_TEMP.py]
2026-08-12 refactor: net1/net2 left hand-drawn, and the number that says why
    Told as stories they close two OPENS (11 -> 9) and cost sixteen DRC
    (54 -> 70) -- on M2 or on M5, and at every column lane swept (10..15).
    The strip has constraints the channel does not know: the JNWTR cells
    put an M1-M4 cut stack in their AVSS and AVDD columns, 31500..40300 and
    58500..67300 from the strip's left edge, and a column landing on one
    ties every pin it passes to a supply. Until that is written down beside
    the channel, these two are better hand-drawn.
    Conversion so far, against the hand baseline:
    DRC 72 -> 54
    opens 13 -> 11
    worst component 8 -> 6 nets
    nets shorted 24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
    [LELO_TEMP.py]
2026-08-12 feat: LELO_TEMP is made of subcells, and has no top routing left
    Carsten's restructure: collect the two comparators into one subcell,
    let the logic strip be one, and take the hand routing out.
    class ccmp(Stack): match = r'^x[23]_ccmp$' # was two classes
    routes = [] # -> made of subcells
    hierarchy() then splits the netlist and builds LELO_TEMP_BIAS,
    LELO_TEMP_CCMP and LELO_TEMP_DIG as real cells, and the top
    instantiates the three.
    LELO_TEMP 5 DRC (was 54, and 72 before the conversion)
    LELO_TEMP_BIAS 0
    LELO_TEMP_CCMP 5 <- all five, in one subcell
    LELO_TEMP_DIG 0
    shapes 4152 -> 3704, wire()/stk() calls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
2026-08-12 feat: mirror the upper comparator about x, so the pair is symmetric
    Carsten's suggestion. A matched pair placed as two identical copies
    repeats the same edge at the seam; mirrored, the two halves meet edge
    to mirrored-edge -- the same argument CellGroup.mirror() makes for a
    column about its vertical axis, taken to the horizontal one because
    these two are stacked.
    LELO_TEMP 5 DRC -> 3
    LELO_TEMP_CCMP 5 DRC -> 3 (all of them)
    shorts 16 -> 13
    opens 11 (unchanged -- the top is still unrouted)
    The pair now meets tap strip to tap strip, and the two reset-switch
    columns sit at opposite corners instead of both on the same side.
    The ports come through t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
    [LELO_TEMP.py]
2026-08-12 fix: 2 um at the seam, because the caps are what sets it
    Mirroring put the two comparators' MiM cap arrays face to face at 0.44
    um. Two rules bind there and the second is the one that matters:
    capm.2a cap to cap 0.84 um
    capm.11 cap to unrelated M4 1.34 um <- binding
    so opening the seam to 1 um cleared capm.2a and lit capm.11 eight
    times, 3 DRC -> 4. Swept: 1.5, 2, 2.5 and 3 um all give 2, so 2 um is
    the knee and the rest is air.
    LELO_TEMP 3 DRC -> 2
    LELO_TEMP_CCMP 3 -> 2 (both met1.2 now; no cap rule left)
    LELO_TEMP_BIAS 0 LELO_TEMP_DIG 0
    shorts 13, opens 11 -- unchanged
    tile 157.6 x 109.5 against 161 x 111.52, so the g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
    [LELO_TEMP.py]
2026-08-12 feat: the logic strip routes its own nets, on lanes
    Starting the subcells' own DRC/LVS. LELO_TEMP_DIG carried
    `beforeRoute: return True`, which claimed the subcell as already
    routed -- true when the top hand-routed every net into it, and
    meaningless once the top's routing was removed. LVS counted 25 nets in
    the layout against 18 in the schematic: seven split.
    Dropping the claim let the built-in router take four of them and left
    one short. Left to itself it put RST_A, RST_B and net2 in ONE column on
    M2 and bridged all three -- the same failure as the top level, and the
    same cause: no lane budget. So the strip registers a channel over its
    own width and each net gets a lane.
    Lane spacing swep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
    [LELO_TEMP.py]
2026-08-12 doc: LELO_TEMP_BIAS's mismatch is a missing wire, not a naming bug
    Carsten asked why the schematic would have wrong net names when both
    sides come from one hierarchy. It should not, and it does not -- the
    generator was wrong and is now fixed (the bus-pin commit before this).
    Verified after it: the ports agree exactly, nine of them, same names
    and same order, .mag port indices 1..9 against the .subckt line.
    What is left is one net that is not drawn. LPI closes the loop from
    the block's LPO pin back to its LPI pin, both ends INSIDE this
    subcell, and the top used to draw it by hand -- so it went when the
    top's routing went. LVS: 10 nets in the layout against 11. checkroutes:
    OPEN net=LPI. That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
    [LELO_TEMP.py]
2026-08-12 feat: LPI told as a story -- LELO_TEMP_BIAS is LVS clean
    LELO_TEMP_BIAS 0 DRC, "Circuits match uniquely"
    Two things were wrong and only one of them was the missing wire.
    The story draws the loop the way the picture says: out of the block's
    LPO pad, up to M5, east to the empty strip at the right edge, down to
    the LPI bar's own row, back to M3, and in along the bar -- which the
    bar already reaches. No search has to discover any of it.
    But the net stayed open with the story in place, because returning
    None left the BUILT-IN ROUTER free to route LPI as well, and it drew a
    bare M2 vertical from pin to pin: x 712300..715300, straight up 35 um
    through the block's own device metal. That is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
    [LELO_TEMP.py]
2026-08-12 feat: the comparator pair crosses its own seam, and is LVS clean
    LELO_TEMP_CCMP had been left to the built-in router, which drew two
    straps no design rule catches and LVS does -- an M1 riser up the right
    edge tying VDD to VDD straight THROUGH both VSS rails, and a full
    height M2 bar at x 205000 crossing VO, VS and VBP2 inside both
    comparators -- and gave up on the three signals that actually cross
    the seam (`no path`, 520000 away).
    The pair claims its own routing now, as five stories. Mirrored, it is
    its own coordinate system: every shared net has its two pins at the
    same x and mirrored y, so each story is written once with a pin anchor
    and its opposite. What the mirror does not give is a w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
    [LELO_TEMP_BIAS.sch, LELO_TEMP_CCMP.sch, LELO_TEMP_DIG.sch]
2026-08-12 feat: the logic strip is a ladder, and it is LVS clean
    LELO_TEMP_DIG's five internal nets were railed with vchannel tracks --
    `vtrack=16` and `23` out of a channel that has 16 -- so RST_A and
    RST_B were carried OUTSIDE the cell and LVS found each of them split
    between its gate side and its drain side, with two more gates on VSS.
    They are told out now: a lane per net on M2, an M3 or M5 stub in to
    each pin, one via at each end. Every JNWTR cell puts its inputs at
    13500 and its outputs at 36000 and carries nothing above them but two
    M4 supply bars, which is what makes the shape work at all.
    What the shape cost, each measured once:
    - a lane's pad is 8800 wide, so lanes are 12000 apart, and th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
2026-08-12 doc: top_plan says what is actually there
    The file described a flat top with 778 lines of hand routing, 93 DRC
    and "one LVS line left". None of that survived the subcell conversion,
    and the numbers were measured against a netlist that was itself wrong.
    What is there now: three blocks that each verify -- BIAS, CCMP and DIG
    all "Circuits match uniquely" -- placed and not joined. The top
    declares `routes = []`, so the 39-against-24 nets LVS reports is not a
    defect to hunt, it is the work.
    The file now carries the floorplan as placed, the net list with each
    block's published ports, the three things in afterPlace/beforePaint
    that are dead or latent since the conversion, and the one blind spot
    t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
2026-08-13 refactor: the leg to the row is li, and the second cut goes
    Every stub left its pin with a via to M2, went one step up the column,
    and vied again -- two cuts 3000 apart, with pads that overlapped each
    other, on a leg 3 um long. RST_A had six cuts for two pins.
    The pin is li, the column is li: the leg rides it and there is one cut
    per stub end, where the leg meets its crossing layer. 36 cuts to 24,
    and LVS still matches uniquely.
    It is also the only leg this cell can CHECK. A JNWTR cell publishes
    its li and nothing else above it, so the row search now tests each
    candidate leg -- and the pad that lands at its end -- against the real
    geometry of the cells it crosses, which is impossible on M2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
2026-08-13 fix: a row sits ON its pin or two steps off it, never one
    klayout says what the li errors were, and it is one number:
    JNWTR_NRX1_CV (1.35,8.65; 2.25,8.95) the pin
    LELO_TEMP_DIG (1.65,8.58; 1.95,8.65) the leg -- 0.30 wide, 0.07 tall
    LELO_TEMP_DIG (1.32,8.26; 2.16,8.58) the cut's li pad, 0.84 wide
    The pad that ends a leg is as wide as the pin it serves and the leg is
    a third of that, so at ONE step off the pin the pad's li stops 700
    short and leaves a 0.33 um notch either side of the leg. li.3 wants
    0.17. One step is the worst distance there is: too far to overlap, too
    close to clear.
    So the row search skips it. k=0 is tried first -- the cut lands on the
    pin, one cut and no l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
    [LELO_TEMP.py]
2026-08-13 fix: the strip asks the cells, and 11 DRC become 7
    The row search checked its stubs against the published M1 -- all it
    could see -- and guessed the rest: a stub had to clear its cell's rail
    by 7800, a number measured off DRC boxes rather than read off the
    rail. It now asks `blockCell()`, which knows what a JNWTR cell places
    at every depth, and checks three shapes on the layers each one really
    occupies: the li leg, the pad that ends it, and the crossing run from
    the pin's column out to its lane.
    The 7800 is gone. So is the rail band it stood for.
    Two things the check found the moment it was wired in:
    - A NET OWNS WHAT TOUCHES ITS PINS. The li reaching a pin is drawn
    inside the cell -- (3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
    [LELO_TEMP.py]
2026-08-13 feat: the strip is ordered by its own nets -- 0 DRC
    ORDER IS THE ROUTING BUDGET, and this one was working against it. The
    powerdown chain sat at the TOP of the strip while the OR gate it feeds
    sat at the base, so PWRUP_N spanned six cells and 150 um -- and it was
    the net stuck on the lane between the two M4 supply bars, the one lane
    an input pin can never reach. Total net span, in cells: 12.
    Put the chain at the base, beside the gate it drives, and it is three
    adjacent cells. Span 8, and four of the five nets are adjacent-cell
    hops.
    That makes the middle lane unnecessary, which is the real win: with
    PWRUP_N local, the five nets fit on the three lanes that CAN be
    reached from M5, two of the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
    [LELO_TEMP.py]
2026-08-13 feat: the top's supplies, and the three things that hid them
    VDD_1V8 and VSS both match the schematic now. Five ties, in empty
    space, and each of the first four attempts failed differently:
    - A PATH MADE IN beforePaint IS NEVER WALKED. The route phase is over
    by then, so the three ties came out as three empty Paths and the
    strip read as floating. Ring attachment belongs in beforePaint --
    the rings are final there -- so the story asks to be drawn:
    `p.route()`.
    - A RING IS NOT A PLACE. `end()` lands on the stop rect's CENTRE, and
    the centre of a ring spanning the tile is the middle of the cell:
    the first riser drew its last leg 60 um west, across three blocks.
    Harmless on VSS, w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
    [LELO_TEMP.py]
2026-08-13 refactor: the ties are routes, so they live in beforeRoute
    They were built in beforePaint and then asked to draw themselves,
    which is not the API saying anything -- it is a route in the wrong
    phase with a call bolted on to compensate. Routes go in beforeRoute,
    with every other route, and the phase draws them.
    Two helpers went with the bandaid. `_slice`, which handed each story a
    made-up piece of the ring to end on, exists only because `end()` lands
    on the stop rect's centre and a ring spans the tile. A ring is a ROW,
    not a place: no tie ends on one now, they `movey` to its row and drop
    a via, which is shorter to write, needs no invented geometry, and says
    what a supply tie actually does.
    W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
    [LELO_TEMP.py]
2026-08-13 feat: the four bias currents cross the tile as one bundle
    b = layout.bus(nets, "M5", starts=starts, stops=stops, lanes=2)
    b.start()
    b.movey(b.track("cband", 30))
    b.down("M4")
    Four nets, one story. Each member takes the row two lanes above the
    last and turns down at its own column, and where the bundle ends they
    are Paths like any other: <3> and <2> drop into the gap west of the
    comparators to reach the pins at the bottom of the pair, <1> and <0>
    carry on over the top of it.
    THE ORDER OF THE MEMBERS IS THE ORDER THEY LEAVE IN. The one that
    turns first must be on the lowest row, or its descent crosses the rows
    still travelling east -- which is why the list reads <3>, <2>, <1>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
2026-08-13 feat: the strip publishes M2, not li
    An audit of every port in the hierarchy -- 146 cells, 686 pins --
    found them all on a metal layer and all with metal of their own layer
    underneath. It also found what that check cannot: LELO_TEMP_DIG
    published all EIGHT of its signals on li, because a JNWTR cell's pins
    are li and the strip passed them on as it found them. The level above
    would have had to meet li eight times, on the one layer the design
    reserves for power.
    They are carried up here instead, on rows booked like any other stub
    and checked against the cells' own geometry the same way, and said in
    `afterPorts` -- the only phase where saying it survives.
    A NET THE STRIP ALREADY ROUTES HAS A P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
2026-08-13 doc: what the last flat cell needs to become subcells
    The switch is one line -- `routes = []` -- and the split works: three
    cells with clean ports, the shared bias current re-expressed as a
    channel route with discovered drops, PWRUP_N and the cap rail as
    stories between ports. 150 lines of Rect and Cut reaching into
    x1_cmp, xg1, xg4 and xd1<0> go away with it.
    It stops one net short: the pull's two NMOS sources are not on their
    own cell's VSS rail. As a group inside the parent they were tied by
    addPowerConnection reaching every published supply rect; as a cell the
    subcell must rail them itself, and neither trunk direction nor
    addPowerConnection from inside does it. The plan says what to try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
2026-08-13 feat: the comparator is made of cells
    LELOTEMP_CCMP was the last sidecar in this design whose declared
    pieces stayed groups inside one cell. They are cells now --
    LELOTEMP_CCMP_CMP, _N_G, _CAPS, each matching uniquely and DRC clean
    -- and the 150 lines of Rect and Cut that reached into x1_cmp, xg1,
    xg4 and xd1<0> by name are gone with the groups that made them
    possible. What crosses the three of them is one channel route and two
    stories.
    LELOTEMP_CCMP Circuits match uniquely, DRC OK
    LELO_TEMP_CCMP Circuits match uniquely, DRC OK
    LELO_TEMP DRC OK (its own nets are still to route)
    Four things this cost, all now written where they were learned:
    - as groups the pieces were rail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
    [LELOTEMP_CCMP_CAPS.sch, LELOTEMP_CCMP_CMP.sch, LELOTEMP_CCMP_N_G.sch]
2026-08-13 feat: six of the top's nets are told, and the strip is measured
    The top level routes VC, PWRUP_N, PWRUP_B, CMPO_A/B, RST_A and RST_B
    as stories now, through the corridors the floorplan opens (lband,
    dband, the bands over the short blocks) and the ones the pair leaves
    free, which it is ASKED for rather than told: addBlockChannel takes
    the span a riser needs clear and comes back with the corridor
    nearest the pin. There is not a coordinate in any of them.
    The lane plan is the whole of it, because on one layer a crossing is
    a short: risers over the pair go west to east with decreasing band
    tracks, descents go west to east with increasing ones, and the last
    leg into a pin is on M4 while every de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
    [LELO_TEMP.py]
2026-08-13 build: rebuild every block on the reworked framework
    Geometry only -- the .mag and .cic the tools emit, regenerated after
    the sidecar rework (cicpy 0ef9ff8..9d84535: a declared piece is always
    a cell, the design defines it, one kind of cell, the block view walks
    the groups and is rebuilt when the cell changes).
    Verified as committed:
    LELOTEMP_BIAS_IBP match uniquely, 0 DRC
    LELOTEMP_OTAR match uniquely, 0 DRC
    LELOTEMP_CCMP match uniquely, 0 DRC
    LELO_TEMP_CCMP match uniquely, 0 DRC
    LELO_TEMP_DIG match uniquely, 0 DRC
    LELO_TEMP 72 DRC; its own nets are the open work
    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
2026-08-13 feat: the logic strip publishes on M5, and is clean
    Its ports were M2 pads at the pin, and its OUTPUT pins sit at
    block-x 36000 -- inside the full height M4 supply bar every JNWTR
    cell carries. Nothing above M3 could land on them, which is every
    neighbour the strip has.
    M5 is the one layer those cells do not use at all, so that is where
    the ports go. Where a port RISES is measured, not chosen: the strip
    asks its own block view for the columns free of M4 (exit0..2, and
    they come back exactly where its own notes say the supply bars are),
    and then
    * a pin already in a free column rises where it stands;
    * a net with a LANE rises on its lane -- it has metal in a free
    column already, and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
2026-08-13 feat: the top is down to one open net
    VC and IBP_1U<2> are closed. Both were the same mistake -- `landing`
    resolved against something other than the pin -- and both are told
    with `pin("xccmp", NET, axis)` now, which traces to exactly the pin
    the pair publishes.
    LELOTEMP_CCMP, LELO_TEMP_CCMP, LELO_TEMP_DIG: match uniquely, 0 DRC
    LELO_TEMP: 28 DRC, one net open
    What is open is PWRUP_B on the PAIR. Its pin is in the middle of the
    comparator's own row and that row east of it is the other
    comparator's PWRUP_N bar on M5, so anything coming down onto the pin
    lands on PWRUP_N. The net does have metal in the pair's one clear
    corridor -- the seam story runs it up the free column on M2 -- and an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
    [LELO_TEMP.py]
2026-08-13 feat: the pair publishes PWRUP_B on M5, in its own free column
    Half of the last open net. Its pin is in the middle of the
    comparator's row and that row east of it is the other comparator's
    PWRUP_N bar, so nothing above M3 can land on the pin -- but the seam
    story already runs the net up the one column that is clear top to
    bottom, and a sixth story now takes it from there to M5. The port is
    where that story ENDS, which the path itself reports: computing the
    same track from outside the path resolves it with a different pitch,
    and the pad landed beside the riser and published a port joined to
    nothing.
    LELO_TEMP: 28 DRC, PW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
    [LELO_TEMP.py]
2026-08-13 doc: what the top has room for, measured
    The pair's PWRUP_B port is where it should be -- M5, high in the free
    column, above the seam ring -- and the tile still will not take a leg
    down to it. Four routes tried, in layout nets against the schematic's
    24:
    no leg at all 18
    M5 down the column from cband 15 cuts the five M5
    band legs, which
    cross that x
    M4, crossing above the bundle 16 the riser in lband
    cut the bundle's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
2026-08-13 feat: the top's lane plan, corrected by what the checker named
    `cicpy sch2mag --check-connectivity` names the BRIDGE that makes each
    short -- the two shapes, their nets and the routes that drew them --
    and every fix here came from one of those lines rather than from
    reading geometry:
    * the two comparator outputs rose at the same x. Their pin column
    is OUTSIDE the corridor the pair leaves, so "so many lanes from
    the pin" clamped both to its east wall.
    * the eastern risers climbed through the western legs. The rule was
    upside down: the riser furthest east must stop LOWEST, so the
    legs that cross it are above it.
    * the one whose pin is lower must take the farther riser --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
    [LELO_TEMP.py]
2026-08-13 doc: what the top level has room for, and the instrument for it
    The connectivity checker names the BRIDGE that makes each short --
    both shapes, both nets, and the routes that drew them. Every fix in
    the last round came from one of those lines; none came from reading
    geometry, which is what the hours before it were spent on.
    Written down: the lane budget of each corridor and why (dband has
    eleven lanes and four usable -- a cap halo takes two and a supply tie
    takes three); the two ordering rules that came out of bridges (risers
    west to east with falling tracks; of two nets walking west, the lower
    pin takes the farther riser); that there is no corridor over the
    strip at all, because it routes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
2026-08-13 feat: the top is DRC clean, and RST_B stops landing on RST_A
    RST_B's descent over the strip aimed at `digfree`, a corridor that
    registered nothing because the question was net-blind (fixed in
    cicpy). Every step that named it resolved to a bogus x and the leg
    came down on RST_A: netgen saw one net where the schematic has two,
    23 against 24, and that was the whole LVS failure. Asked for its own
    net the strip answers with the column RST_B's port already sits in,
    and the two nets are separate again.
    DRC: 20 -> 0, on the top and on all three subcells.
    * PWRUP_N off lband lane 0. Hard against the bias block's edge, its
    trunk ran 0.15 um from the block's own M5 where met4.2 wants 0.30.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
    [LELO_TEMP.py]
2026-08-13 doc: the strip's top-edge exit, and the three walls it ran into
    Kept beside the design rather than in it: PWRUP_B_1V8 still does not
    reach the strip, and this is how far the attempt got.
    The mechanism works. The strip carries the port up its own free M4
    column -- `_exits` is freeColumns("M4"), full height, and the pin's
    column is one of them -- jogs west in the 8 um band above the topmost
    cell, where there are no supply bars, and publishes at the top edge.
    M5 could not do it: net1, net2 and RST_B cross that x on M5 at four
    rows. The port moves from (41600,42300) mid-block to the top edge,
    which is what the tile needs.
    Three walls, each measured, none of them closed:
    * OSC_TEMP's M2-M5 s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
2026-08-13 doc: the tapcell buys height, and the strip's problem is lanes
    Tried, measured, not kept. The schematic gains xtap_dig_1 (a second
    JNWTR_TAPCELLB_CV on VDD_1V8/VSS) and the dig class matches
    xtap_dig_\d+ and puts it at the top of `order`; netgen counts 31
    devices against 31, so the pair is honest.
    WHAT IT FIXED. The strip grows 16 um to 200000 and OSC_TEMP's M2-M5
    stack, which sits just above the topmost cell because its driver x5
    is the topmost cell, stops sharing the one band above the cells with
    a riser heading for the top edge. Together with sending a top-exit
    net to the ROOMIEST free M4 column rather than the nearest -- nearest
    is exit1, which OSC_TEMP is already in -- every cell goes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
2026-08-13 doc: escaping west works on M4, and then meets lane t0
    The left side is the right instinct and it gets further than the top
    did. The strip's west sliver -- exit0, block x 0..31500 -- is free on
    M4 for the full height, and it is the one column a neighbour can
    reach without crossing the block: dband has no lane left and there is
    no column over the strip on M5.
    WHAT THE LAYER WAS WORTH. Walking west and rising to M5, as every
    other port does, put the pad on RST_B: its rungs cross the sliver on
    M5 at two heights. Ending the walk on M4 instead passes under all of
    them, and the port publishes at block (8800,42300)-(17600,45700) --
    on the west edge, at the pin's own row, which is what the tile nee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
2026-08-13 feat: the strip escapes west, and a tapcell is what makes room for it
    PWRUP_B_1V8 now leaves LELO_TEMP_DIG on its WEST EDGE -- M4, block
    (-1400,54300)-(7400,57700) -- instead of on a pad buried at
    (41600,42300) where no neighbour could reach it. Every cell is DRC
    OK and nothing is shorted.
    THREE WALLS, AND EACH IS CROSSED WHERE IT IS THINNEST. The leg west
    from the pin meets a supply column, a lane and RST_B's rungs, and the
    mistake in every earlier attempt was crossing them all in one place.
    * RST_B's rungs are M5. The walk used to end `up("M5")` like every
    other port, and landed on them. Ending on M4 passes underneath.
    * The supply column is crossed at the PIN'S OWN ROW, where it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
    [LELO_TEMP.sch, LELO_TEMP_DIG.sch]
2026-08-13 doc: the top-edge exit, and the two things still between it and LVS
    Closer than anything before it, and still not clean, so it stays
    beside the design.
    The strip carries PWRUP_B up the west sliver to its TOP EDGE -- M4,
    block (-1400,196600)-(7400,200000) -- and dig is DRC OK there. That
    removes the descent entirely: the port is in the band the top already
    travels in, so the leg is east along cband and straight down onto it,
    no dband lane needed. Best measured: 23 nets against 24, DRC OK on
    every cell.
    TWO THINGS LEFT, and they are separate.
    * The leg merges PWRUP_B with PWRUP_N and RST_A. Not in lband --
    lanes 3, 5, 7 and 9 all give 23 -- and not in the IBP bundle,
    which came ou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
2026-08-13 feat: the maze router connects PWRUP_B, and VC is the last thing in it
    `PBMAZE=M3 make mag CELL=LELO_TEMP` hands this ONE net to the maze
    router -- one addConnectivityRoute, everything else still the hand
    lane plan -- and it does what six hand routes could not: all three
    fragments of PWRUP_B_1V8 join. Layout 24 nets, and the net itself is
    whole for the first time.
    The AUTOROUTE experiment in this file says the router LOSES, and that
    is still true of what it measured: twenty nets sharing two layers,
    with no idea which layers the blocks own. One net threading a tile
    whose other twenty are already drawn is a different question, and the
    answer is different.
    Off by default. What stops it being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
2026-08-13 doc: the router finds a legal path; telling it back as a story does not
    The two-pass idea is right and the search proves it. Run against the
    FINISHED .cic -- where every hand story is already painted and is
    therefore an obstacle the search can see, which it cannot be during
    beforeRoute -- and CONSTRAINED to M3/M4, it answers:
    ccmp->dig M3 1347000,712000 -> 1422000,712000
    M4 1422000,712000 -> 1422000,72000
    M3 1422000,72000 -> 1494000,72000
    3 runs, 2 vias, NOTHING blocked
    That is a legal path, and it is the first one anything has produced
    for this net. 1422000 is dband track 0 -- the lane this file calls the
    cap bank's halo and never spe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
2026-08-13 doc: the band below cmp gets the port to an edge, and the leg to it is next
    Your channel is there and the placement already makes it: inside
    LELOTEMP_CCMP every sub-block starts at y=24000 and the VSS rail tops
    out at 9000, so 15 um of full-width channel sits below cmp. Mirrored,
    the upper comparator's lands just under the pair's top edge -- beside
    cband, which is where the level above travels.
    IT MOVES THE PORT, which is the thing eight routing attempts could not
    work around. PWRUP_B_1V8 goes from (334200,696000) -- a third of the
    way in, seven eighths up, inside the comparator's own routing with the
    cap bank east and its M3/M4 west -- to the pair's WEST EDGE at
    (0,753900)-(6000,759900). a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
2026-08-13 feat: LELO_TEMP is DRC and LVS clean
    LELO_TEMP, LELO_TEMP_BIAS, LELO_TEMP_CCMP, LELO_TEMP_DIG:
    DRC OK, and "Circuits match uniquely" on every one.
    PWRUP_B_1V8 was the last open net, and it was never a routing
    problem: it was published in the MIDDLE of the comparator pair, at
    block (334200,696000) -- a third of the way in, seven eighths up,
    inside the comparator's own routing with the cap bank east of it and
    its M3/M4 west. A port in the middle of a block cannot be left
    without crossing the block, and eight routing attempts all died
    crossing it.
    UNDER THE CAPS IS EMPTY, and that is what moves the port. A MiM lives
    on the upper metals -- the bank owns M4 from 339300 and M5 from
    355800 --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
    [LELO_TEMP.py]
2026-08-14 doc: the layout flow is sidecars and hierarchy now
    The document still described `cicpy sch2mag` by hand, a `<CELL>.py`
    that refines a placement, and a route-short pass as the debug loop. The
    flow moved underneath it.
    Written down: that the sidecar IS the cell and its classes are real
    ones; that what a cell is made of is CONTENT and not a flag -- a cell
    declaring `routes` is assembled from subcells, one that does not places
    stacks of devices, and `routes` says how the pieces are joined rather
    than whether they exist; that membership and ports are properties of
    the NETLIST, known before anything is placed, which is what lets a
    subcell be built as a cell from its own subcircuit; and that `make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
2026-08-14 build: rebuild on the current cicpy
    The .cic carries the story steps, so it moves whenever the framework
    that resolves them does. All four cells verify unchanged: DRC OK and
    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
2026-08-14 docs: correct and reorder the layout flow page
    Reviewed documents/layout_flow.md against the code. Four errors:
    - the `routes` rule was wrong. A cell is made of subcells because it
    HOLDS subcell classes; `routes` says how they are joined and may be
    empty, as it is here. Fixed in the two design files that repeated
    the claim, and in work/Makefile.
    - `self.assembled` does not exist, and it asked the reader to branch
    on "one of the two passes" -- there is one pass.
    - `make gds cdl lvs` with "gds FIRST or extraction is stale": xlvs
    extracts design/<LIB>/<CELL>.mag with magic, GDS is not in that
    path. Now `make cdl lvs`.
    - `make mag` is local to this IP's work/Makefile, not a shared t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
    [LELOTEMP_OTAR.py, LELO_TEMP.py]
2026-08-14 docs: second pass on the layout flow; drop the AUTOROUTE experiment
    Verified the page's claims against the code and the .mag files rather
    than against itself. Corrections:
    - the route-short report does not run on a plain build. It is behind
    --check-connectivity (cic.py:435), and the message format shown was
    invented; the real one carries component/nets/bounds/callsite.
    - the collision report section named _signal_routes in LELO_TEMP.py,
    which does not exist -- the method is _signals. Section deleted; it
    duplicated the debugging one.
    - the JNWTR paragraph was wrong where being wrong shorts nets. A cell
    publishes only li/poly/M4, but places two JNWTR_cut_M1M4_2x1, and
    that cut pai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
    [LELOTEMP_CCMP.py, LELO_TEMP.py]
2026-08-14 sim: Lay runs, block testbenches, and three spec path bugs
    The Lay view could not run. The layout groups blocks into
    LELO_TEMP_BIAS / LELO_TEMP_CCMP wrapper cells the schematic does not
    have, and the extraction is flat, so every internal node carries the
    wrapper in its name: VC is xbias.VC, x1_ibp.VR1 is
    xbias.x1_ibp.xr_lad.VR1. Only the four ports are common to both views.
    LVS compares ports alone, so this surfaced as "no such vector as
    v(xdut.vc)" rather than as a mismatch. Split the probes and the vc
    measurement with #ifdef Lay, which cicsim applies to .meas as well as
    .spi, and dropped three saves (CMPO, clk, rst) that name nets existing
    in neither view.
    Sch was re-run because it was ge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
2026-08-14 doc: describe OTAR and CCMP
    Both cells had a section in the generated schematic page with a symbol
    and no text, because gendoc takes the prose from <CELL>.md and neither
    existed.
    OTAR is the same current mirror OTA as LELOTEMP_OTA rebuilt from the
    REY_ATR cells, so the note covers what is actually different: the tail
    resistor to VDD rather than a bias from the loop it is closing, and the
    low threshold input pair, which is what buys the headroom the 1.7 V
    corner needs.
    CCMP is where the period comes from, so the note is the half period
    expression with the comparator delay in it, plus the measured effective
    capacitance and delay in both views from the new sim/LELOTEMP_CCMP
    testbench.
    Siblin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
2026-08-14 wip(bias_ibp): draw the fill dummies as vector instances
    The fills were the bulk of the page: 19 devices and their 76 supply pin
    symbols out of 137 placements, 69% of the schematic. The rest of the
    cell already uses vector instances for repeated devices -- xd1[9:0],
    xd2[2:0], xd3[5:0], xcc[4:0], xca2[3:0], xca5[7:0] -- and xcc is the
    identical electrical case, a decap column with all four terminals on
    VDD_1V8 drawn as one symbol. The fills were the one run left expanded.
    xfill_p_su_0 .. _10 -> xfill_p_su[10:0]
    xfill_p_cc_0 .. _7 -> xfill_p_cc[7:0]
    137 placements -> 52. The netlist is unchanged apart from the naming:
    74 devices before and after, identical once the index syntax is
    n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
    [LELOTEMP_BIAS_IBP.sch]
2026-08-14 fix(bias_ibp): keep p_su's blocked declarations, and rebuild
    The previous commit dropped p_su's wires block, on the reading that the
    router searching afresh was harmless. It is not: left to draw VDD_1V8,
    VD1 and VSU itself, the router shorts VDD_1V8 to VSU, and netgen
    reports them as one node. Those three `blocked` lines are not a
    workaround for a stale block, they are the specification -- these nets
    are not for the maze router.
    They survive the rename now because a stale wires_key no longer
    condemns a whole block, only the wires that declare a coordinate
    (cicpy 47f2ecc). The key still mismatches, loudly, and that is correct:
    the fills really were renamed. What changed is that a declaration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
    [LELOTEMP_BIAS_IBP.py]
2026-08-14 feat(bias_ibp): own the bandgap bipolar instead of borrowing it
    LELOTEMP_BIAS_IBP instantiated JNWBIAS_BIPOLAR out of the shared
    jnw_bias library, so this design's kdrc result depended on a cell no
    one here maintains -- and that cell was failing: 10x psdm.1, the
    substrate guard ring's generated p-select ending 0.29 um from the pnp
    array's where 0.38 is wanted. magic's deck called it clean, which is
    how it rode inside the bandgap unseen into every design that uses it,
    and those 10 were the whole of LELO_TEMP's kdrc failure.
    Copied to LELOTEMP_BIPOLAR with the clearance fix already in it (the
    ring out 0.1 um on all four sides, its contacts, locali and the VSS
    strap moving with it, so the cont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
    [LELOTEMP_BIAS_IBP.sch, LELOTEMP_BIAS_IBP_BIP.sch, LELOTEMP_BIPOLAR.sch]
2026-08-14 fix(lelo_temp): antenna diodes on CMPO_A and CMPO_B
    The last two errors in the tile: MP0 over the limit of 400 at 450.6
    and 488.2, both on plane metal3. Gone -- `make ant` finds 0.
    THE REPORT DOES NOT NAME THE NET, and the nets were not the ones this
    was started on. antennacheck gives a gate box, one rect of the
    offender, and a device name that is `MP0` for both violations. A
    diode was hung on PWRUP_N first, and both ratios came back unchanged
    to the third decimal, which is what a diode on the wrong net looks
    like.
    The rects name the nets themselves once put next to the track map:
    (1456400,170200) and (1444400,82200) sit exactly on the two lanes
    `cicpy tracks` attributes to CMPO_A and CMPO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
    [LELO_TEMP.sch]
2026-08-14 feat(cmpr): REY_ATR comparator with an LVT input pair
    LELOTEMP_CMP's PMOS input pair cannot reach the cold end of its own
    input range. VC is CTAT, so it peaks at 0.845 V at -40 C, and a
    standard pfet at L=0.22 needs |Vsg| = 0.983 V at 2 uA there. VS
    would have to sit at 1.83 V, above the supply, so it pins at the
    rail and the tail transistor drops into triode: 43 nA instead of
    its designed few uA. The comparator then crawls, and its delay is
    added to every oscillator half period.
    delay at -40 C, Ksf, 1.7 V: 170.1 ns -> 6.9 ns
    ramp overshoot past VC: 680 mV -> 27.6 mV
    LELOTEMP_CMPR is the same topology on REY_ATR devices with the pair
    on REYATR_LVT_PCH_8C5F0. LVT has no shor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
    [LELOTEMP_CCMPR.sch, LELOTEMP_CMPR.sch, LELO_TEMP.sch]
2026-08-14 layout(cmpr): order the columns from the netlist, not the width budget
    Placement only -- beforeRoute is reduced to the two supply rings and
    every signal route from LELOTEMP_CMP is deleted rather than carried
    over. CMP's track numbers were tuned for JNW_ATR's 2.56 um columns and
    a track is an offset from the net's OWN pins, so on REY_ATR's 8 um
    columns six nets landed on M3 track t24 together.
    Five nets cross between columns (netlist_info): VBN1, VO1 and VIP into
    p_diff, VO into p_mirr_tail, VBP2 into p_mirr_tail. Weighting each by
    the columns it spans, the four orderings score
    load+xg | bias || diff | tail = 11 <- what it had
    bias | load+xg || diff | tail = 8 <- what it has no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
    [LELOTEMP_CMPR.sch]
2026-08-14 layout(cmpr): supplies to the guard, and the port plan in the stack order
    Two fixes to the placement, and the routing analysis written down.
    1. THE SUPPLY SHORT. The previous commit was DRC clean and still
    wrong: with addPowerConnection and NOT ONE SIGNAL ROUTE in the
    cell, checkroutes found two components of 31 rects,
    VBN1,VBP2,VDD_1V8,VIN,VIP,VO,VO1,VS
    IBP_1U,VBN1,VBP2,VIP,VO,VO1,VSS
    -- every signal shorted to a supply before routing began.
    addPowerConnection copies the PIN rect and stretches it to the ring
    on the pin's own layer; REY_ATR pins overhang, so an upper device's
    source dragged M1 down across the drain and gate of everything
    below it. LELOTEMP_C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
    [LELOTEMP_CMPR.py]
2026-08-14 layout(cmpr): route the signals -- 0 shorts, ports match, 3 nets open
    WIP: this cell does NOT pass LVS yet. It is committed because it is a
    long way past the last one and every step is attributed.
    checkroutes 0 shorts, 3 opens (was 1 short over 6 nets)
    make drc 38 errors (63 on the cell this replaces)
    netgen "Cell pin lists are equivalent" -- all 9 ports match
    and the port shorts are gone; 21 devices vs 18 and
    18 nets vs 13, which is what the 3 opens look like
    once netgen merges parallel devices
    Four shorts closed, and not one of them was two wires crossing on a
    layer. Every one was a via COLUMN or a rail sitting on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
    [LELOTEMP_CMPR.py]
2026-08-14 layout(cmpr): use addChannelConnection for VBP2, and correct the diagnosis
    Still 0 shorts, 3 opens -- no change in the verdict, but the VBP2
    diagnosis in the docstring was wrong and is now right, which is worth
    more than the guess was.
    WRONG: "the two halves draw separate bars that never meet, suspect
    addChannelRoute and _resolveChannelOptions disagreeing on the track
    coordinate". They do not disagree. Both halves resolve to the same
    bandy329000, and addChannelConnection -- which exists for exactly this
    case, paving the union of successive calls on one channel track --
    lays M3 (38400,366500)-(320800,369500), bias to tail, the full width
    it should be.
    RIGHT: the bar is fine and the RISER is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
    [LELOTEMP_CMPR.py]
2026-08-15 layout(cmpr): rewrite as a SidecarCell
    Four columns, four subcells: LELOTEMP_CMPR_N_MIRR_BIAS,
    _N_MIRR_LOAD, _P_DIFF and _P_MIRR_TAIL, tiled as one row, with the
    seven crossing nets declared as one bar each on its own track of a
    "band" channel above the columns.
    Why: the flat connectivity router could not finish this cell. About
    twenty builds took it from six merged nets to one and never to zero,
    and not one of the shorts was two wires crossing on a layer -- they
    were via columns and rails on foreign pins, which no track map shows
    and no lane assignment prevents. The stack-level maze router is
    space-aware; the flat one is not.
    The placement is unchanged and carried over verbatim: the colum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
    [LELOTEMP_CMPR_N_MIRR_BIAS.sch, LELOTEMP_CMPR_N_MIRR_LOAD.sch, LELOTEMP_CMPR_P_DIFF.sch, LELOTEMP_CMPR_P_MIRR_TAIL.sch]
2026-08-15 layout(cmpr): stop forcing 1x1 cuts on the drops
    `cuts: 1` on all seven channel routes was wrong twice over. A lone
    1x1 via is the last resort in this technology and a design does not
    get to ask for one -- cut selection already walks 2x1 -> 1x2 -> 1x1
    and takes the first that fits, so forcing 1 removes the two good
    options and leaves the worst.
    And it did not fix anything. It was aimed at the pad overhang between
    ADJACENT drop lanes (a 0.88 um pad on a 0.6 um lane), which is real,
    but the short that remains is two nets sharing ONE lane end to end:
    VIP and VO both publish on n_mirr_load's drain lane, so VIP's drop
    runs 120100..123100 from y 139000 to 410000 and VO's runs the same x
    from 2990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
    [LELOTEMP_CMPR.py]
2026-08-15 layout(cmpr): put the diagnosis in the file, and measure where the DRC is
    Two fixes to my own record-keeping.
    1. The STATE block the previous commit message described was never
    actually in the docstring -- the edit that was meant to add it
    silently matched nothing, and I did not check. It is there now.
    2. Answering a question I had not asked of this cell: is the placement
    clean? I measured that on the flat version and never on this one.
    Built with `routes = []` and subtracted:
    LELOTEMP_CMPR_N_MIRR_BIAS 0
    LELOTEMP_CMPR_P_DIFF 0
    LELOTEMP_CMPR_P_MIRR_TAIL 0
    LELOTEMP_CMPR_N_MIRR_LOAD 12 met1.2, mcon.2
    top, routes = []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
    [LELOTEMP_CMPR.py]
2026-08-15 layout(cmpr): three of four subcells DRC and LVS clean
    LELOTEMP_CMPR_N_MIRR_BIAS 0 DRC Circuits match uniquely
    LELOTEMP_CMPR_P_DIFF 0 DRC Circuits match uniquely
    LELOTEMP_CMPR_P_MIRR_TAIL 0 DRC Circuits match uniquely
    LELOTEMP_CMPR_N_MIRR_LOAD 0 DRC failed pin matching
    All four are 0 DRC and 0 shorts. Three match uniquely.
    What it took, in the order the measurements came:
    - n_mirr_load had 12 met1.2/mcon.2 errors and was the only dirty
    subcell. The search had given VIP and VO the SAME anchor, both
    ('M1','||','trunkright') -- two rails on one terminal 0.12 um
    apart. VIP keeps trunkright, VO takes trunktab.
    - the other 6 were a VSS rail t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
    [LELOTEMP_CMPR.py]
2026-08-15 layout(cmpr): drop the M2 supply rails, and name the n_mirr_load short
    Both from reading the FULL-hierarchy picture instead of the top-only
    one. Top-only shows the paint this cell owns; it hides the metal
    inside the placed cells, which is exactly the metal a rail collides
    with. Every wrong conclusion below was drawn from the top-only view.
    1. n_mirr_bias and p_mirr_tail each carried an unnecessary M2 rail
    for a supply -- VSS and VDD_1V8, both drawn by the search at
    trunkx=-800, outside the cell. The supply already reaches the
    guard column beside every source on M1, and the taps carry it up,
    down and across; the M2 rail is a second path nobody asked for.
    Both declared blocked.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
    [LELOTEMP_CMPR.py]
2026-08-15 layout(cmpr): subcells 3/4 LVS clean; the 4th blocked by a library defect
    N_MIRR_BIAS 0 DRC 0 shorts 0 opens Circuits match uniquely
    P_DIFF 0 DRC 0 shorts 0 opens Circuits match uniquely
    P_MIRR_TAIL 0 DRC 0 shorts 0 opens Circuits match uniquely
    N_MIRR_LOAD 0 DRC 1 short 0 opens 6 of 7 ports publish
    All of this was found with checkroutes now loading the library, which
    is the only reason any of it was visible.
    n_mirr_load, three fixes, each from a BRIDGE line:
    - PWRUP_N_1V8 moves M2 -> M4. Its three gates are on non-adjacent
    rows so its rail spans the column on the gate-tab lane, and that
    lane is the busiest in the cell: every REYATR cell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
    [LELOTEMP_CMPR.py]
2026-08-15 Revert the library-defect claim: REYATR_NCH_2C1F2 is fine
    I claimed in eb27cf1 that 12 of REYATR_NCH_2C1F2's 20 poly contacts
    had no poly under them and that this was what blocked n_mirr_load's
    LVS. That is wrong, and it was an accusation against a shared library
    on the strength of one grep.
    PO and POB are the SAME PHYSICAL LAYER -- both GDS 66/20, material
    poly, in tech/cic/sky130A.tech. I counted contact coverage against
    rects named `PO` only. The POB rects at (20800,14000)-(24000,26000)
    and (52800,14000)-(56000,26000) cover the PCO column exactly, and
    counting PO+POB there are ZERO orphaned contacts in REYATR_NCH_2C1F2
    and none in REYATR_NCH_2C5F0 either. The render shows it plainly: the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
    [LELOTEMP_CMPR.py]
2026-08-15 layout(cmpr): all four subcells DRC and LVS clean
    N_MIRR_LOAD 0 DRC 0 shorts 0 opens Circuits match uniquely
    The last short was the guard jog, not the routing. It is centred on the
    source pin, and REYATR_*_2C1F2's poly contact column reaches that row
    because L=0.22 makes its poly bars 2.2 um where every other cell's are
    9.4 -- so the jog tied xn_mirr_load5's GATE, which is VO1, to VSS. That
    is why VO1 was the one port of seven that never published.
    The fix is scoped to the DEVICE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
    [LELOTEMP_CMPR.py]
2026-08-15 layout(cmpr): drop the 1F2 guard workaround, cicpy handles it now
    The guard_exclude and the compensating addPowerGuardConnection call are
    gone: a cell whose name matches 1F2 gets offsetlow from cicpy itself, so
    this sidecar carries nothing about it.
    Subcells unchanged and clean:
    Docstring updated to say what is actually true now, including that two
    earlier explanations of this bridge were wrong.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
    [LELOTEMP_CMPR.py]
2026-08-15 layout(cmpr): push every subcell wire to the lowest layer that verifies
    Each layer a subcell takes is one the parent's band cannot use, so the
    subcells should sit as low as they will go. Swept n_mirr_load with the
    rest of the cell fixed:
    PWRUP_N_1V8 M2 M3 M4 x VO1 M1 M2
    clean: (M3,M2) and (M4,M2) only
    So PWRUP_N_1V8 comes down from M4 to M3 and VO1 stays on M2. VO1 cannot
    reach M1 at all -- its two pins are on different terminals with no
    common x, so every M1 attempt shorts.
    What each subcell now paints itself:
    N_MIRR_BIAS M1 x28
    N_MIRR_LOAD M1 x37, M2 x3, M3 x2
    P_DIFF M1 x75
    P_MIRR_TAIL M1 x30
    Three of the four are entirely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
    [LELOTEMP_CMPR.py]
2026-08-15 layout(cmpr): rebuild subcells on the full-width supply port
    No design change; picks up cicpy publishing the whole guard column as
    the supply port instead of the half inside the box. Each subcell's
    VSS/VDD_1V8 port goes 4800 -> 9600 wide, which is what the top has to
    land on.
    All four still 0 DRC, 0 shorts, 0 opens, "Circuits match uniquely".
    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
2026-08-15 layout(cmpr): clear the top routes, and put back the first one as a path
    Restart on the top, one net at a time.
    DELETED: the seven ChannelRoute bars on the "band". The bars were never
    the problem -- own tracks, 1.2 um apart -- the DROPS were: every net
    whose pins sit on one terminal of a column publishes at the same x, so
    two nets drop in one lane and a 0.88 um pad on a 0.6 um lane overhangs
    both neighbours.
    BASELINE, with routes = []: 0 DRC, 0 shorts, 7 opens. The tiling, the
    rings and the guard connections add nothing, so every route from here
    is measured against a clean cell.
    Each crossing net has exactly TWO pins, one per subcell, so each is a
    single story rather than a bar with drops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
    [LELOTEMP_CMPR.py]
2026-08-15 layout(cmpr): route 2, VBN1 -- and take the subcell back off M3
    VBN1, load -> diff, 12.96 um. 0 DRC, 0 shorts, opens 6 -> 5.
    Two things this route taught, both measured:
    1. THE SUBCELL MUST NOT OWN M3. n_mirr_load's PWRUP_N_1V8 rail spans
    the whole column height, and M3 is the layer the TOP crosses on --
    so on M3 the first crossing net went straight into it:
    BRIDGE PWRUP_N_1V8|VBN1: M3 (137700,103000)-(140700,343000)
    [PWRUP_N_1V8 < N_MIRR_LOAD] touches M3 (129600,217500)-(227900,220500)
    Four of the seven crossing nets have to pass through that column.
    The rail goes back to M4, where it costs the subcell nothing.
    This reverses part of 8d86819, which pushed ever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
    [LELOTEMP_CMPR.py]
2026-08-15 layout(cmpr): routes 3, 4 and 5 -- VO1, VS, VIP
    route 3 VO1 load -> diff 15.44 um clean first build
    route 4 VS diff -> tail 18.00 um clean first build
    route 5 VIP load -> diff 26.00 um took three tries
    0 DRC, 0 shorts, opens 7 -> 2 (VO and VBP2 left).
    VIP is the first net that could not use the cheap layer pair, and both
    legs were the reason:
    M2 vertical its two pins are 12 um apart in y, so the leg runs most
    of n_mirr_load -- on M2 that is the column's shared
    drain lane, and it cut VBN1's and VO1's landings:
    M2 (124900,139000)-(127900,264500) through both
    M3 crossing moved the leg order instead (cross first, c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
    [LELOTEMP_CMPR.py]
2026-08-15 layout(cmpr): LELOTEMP_CMPR complete -- 0 DRC, LVS matches uniquely
    LELOTEMP_CMPR 34.96 x 39.80 um
    0 DRC, 0 shorts, 0 opens
    Circuits match uniquely
    ..._N_MIRR_BIAS 0 / 0 / 0 match uniquely
    ..._N_MIRR_LOAD 0 / 0 / 0 match uniquely
    ..._P_DIFF 0 / 0 / 0 match uniquely
    ..._P_MIRR_TAIL 0 / 0 / 0 match uniquely
    Routes 6 and 7, and the rule they settled.
    VO, load -> tail. Crossing at its target row put it 2 um from VIP's via
    stack in p_diff, which runs M1 to M5 and blocks every layer at that y;
    crossing at its SOURCE row instead passes over both p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
    [LELOTEMP_CMPR.py]
2026-08-15 layout(cmpr): route the top without M5 -- detour, do not climb
    Every M5 leg is gone. The top now routes on M1/M2/M3 with one M4 leg:
    M1 15 M2 7 M3 7 M4 2 (was M4 1, M5 3)
    LELOTEMP_CMPR 34.96 x 39.80 um, 0 DRC, 0 shorts, 0 opens
    Circuits match uniquely; all four subcells too
    THE LESSON, and it replaces the one in the last commit. Everything a
    crossing leg collides with is a via STACK, and a stack is one pin wide
    -- so the fix is a row a lane or two away, not a whole plane. The
    crossing row is now an anchor plus an offset in PITCHes, stated per
    net, and three of the seven use it:
    VBP2 -1 on p_mirr_tail's row its leg ran through PWRUP_N_1V8's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
    [LELOTEMP_CMPR.py]
2026-08-15 layout(ccmpr): placement -- caps in a row BELOW the comparator
    LELOTEMP_CCMPR 35.00 x 57.10 um, 0 DRC, no routes yet
    Port list is LELOTEMP_CCMP's exactly, checked against both netlists:
    IBP_1U<1> IBP_1U<0> VDD_1V8 PWRUP_N_1V8 PWRUP_B_1V8 CMPO VC RST VSS
    CCMP is the model and this is the simpler cell: CCMP holds the
    comparator, a two-device nmos pull and the caps; here the pull has
    moved inside LELOTEMP_CMPR, so this is the cap bank and the comparator
    and nothing else.
    BELOW, AND IN A ROW. CCMP puts the caps beside the comparator in a
    column. Beside costs WIDTH, which this block has none of -- the tile
    gives it 41 um and the comparator is already 34.96. Below costs
    HEIGHT, of whi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
    [LELOTEMP_CCMPR_CAPS.sch, LELOTEMP_CCMPR_CMP.sch]
2026-08-15 layout(ccmpr): LELOTEMP_CCMPR complete -- 0 DRC, LVS matches uniquely
    LELOTEMP_CCMPR 35.00 x 57.10 um, 0 DRC, 0 opens
    ..._CAPS Circuits match uniquely
    ..._CMP Circuits match uniquely
    Width is 6 um inside the tile's 41; the height is the free dimension
    and this is what it was spent on.
    Three things it took:
    1. THE PLATE RAIL HAD TO RUN ACROSS. plateRail drew a bar down the
    column, right for CCMP's stacked caps and wrong for a row -- it
    joined the middle cap to nothing and left IBP_1U<0> in four
    components. cicpy grows a `direction` for it.
    2. THE TOP NEVER STRAPPED ITS SUPPLIES. Its `s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
    [LELOTEMP_CCMPR.py]
2026-08-15 layout(ccmpr): close the cap-to-core gap, 57.10 -> 51.10 um
    Six microns of empty cell between the cap row and the comparator, and
    the knob that looked like it should fix it did nothing: `place:
    channel` is the FLAT recipe's, and this cell is assembled -- placeHier
    reads a class-level `channel`, whose default 8 um was the gap. Setting
    place: channel to 4, 3 and 2 changed nothing at all, which is how the
    wrong knob announced itself.
    2 um now, and capm.11 is why it can be that close: a MiM claims 1.34 um
    from unrelated M4, and the core's lowest M4 sits at y 139000 in its own
    frame -- 13.9 um above its base, so 15.9 um above the caps. The only M4
    nearer is the cap rail itself, which is their ow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
    [LELOTEMP_CCMPR.py]
2026-08-15 fix(otar): pin_strap -- I broke this cell's LVS and did not notice
    LELOTEMP_OTAR has been failing LVS since the first cicpy commit of this
    session, and LELOTEMP_BIAS_IBP with it because it holds OTAR:
    pre-session cicpy Circuits match uniquely
    every commit since Top level cell failed pin matching
    That commit made addPowerConnection opt-in in SidecarCell's assembly
    branch, for a good reason -- it drags a pin's layer across everything
    between it and the ring on a library whose pins overhang. But OTAR is
    an assembly WITH a ring, so it needed 'pin_strap': True and I only gave
    it to BIAS_IBP. Its ring has been connected to nothing since.
    I did not notice because I verified those tw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
    [LELOTEMP_CCMPR_CAPS.py, LELOTEMP_CCMPR_CMP.py, LELOTEMP_CMPR_N_MIRR_BIAS.py, LELOTEMP_CMPR_N_MIRR_LOAD.py, LELOTEMP_CMPR_P_DIFF.py, LELOTEMP_CMPR_P_MIRR_TAIL.py, LELOTEMP_OTAR.py]
2026-08-15 build: LELO_TEMP on CCMPR -- builds, seams not yet re-aimed
    work/Makefile takes CMPR and CCMPR leaf-first and drops CMP and CCMP;
    LELO_TEMP.sch already instantiates LELOTEMP_CCMPR. (work/ is gitignored
    but work/Makefile is tracked, so this needed -f.)
    LELO_TEMP 154.52 x 118.48 um 2 shorts, 9 opens
    tile 159.90 x 109.46 which is what LELO_TEMP measured
    with CCMP -- the tile IS its old size
    5.4 um narrower and 9.0 um taller. The height is NOT the floorplan: the
    ccmp column is 104.2 um and fits under xbias's 106.46. It is a
    mis-aimed PWRUP_N_1V8 path running to y 1184800 -- 9 um past the top
    edge -- with M5 legs beside it.
    WHY THE S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
    [LELO_TEMP_CCMP.sch]
2026-08-15 layout(ccmpr): RST on the bottom edge, reached by a path
    First of the five seam ports, done the way that works: MAKE the port
    rect at the edge, then route a path to it. Both in the routing phase;
    afterPorts only publishes.
    LELOTEMP_CCMPR 0 DRC, 0 shorts, 0 opens
    Circuits match uniquely, all 9 pins equivalent
    RST M2 (170000,0)-(173200,4000)
    This is also where CCMP had it -- its RST sat at y 0..4000 on the
    bottom edge -- so the level above comes to the same place for it.
    Two things it took:
    - THE PAD GOES IN THE SEAM, not under the pin. Straight down from
    RST's pin is the comparator's gate-tab lane and PWRUP_N_1V8's own
    via stack is in it: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
    [LELOTEMP_CCMPR.py]
2026-08-15 LELOTEMP_CCMPR: VC and CMPO on edges, table-driven
    RST's one-off code becomes a _EDGE_PORTS table: (net, layer, descent
    lane, edge). Each entry makes a pad at the named edge and paths to it
    M1->M2->M3 across->M2 down.
    VC descends east of the cap row, which ends at x 215000. CMPO leaves
    at the top and hops WEST of its pin: the pin is VO's, and VO's own M3
    crossing leaves it eastward at the same y, so an eastward hop runs
    met2.2 against it in every lane tried (152000, 178000, 200000, 290000
    all gave the same 2 errors -- lane-independent, so the fault was at
    the pin end, not the lane).
    35.00 x 51.10 um, 0 DRC, shorts=0 opens=0, Final result: Circuits
    match uniquely.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
    [LELOTEMP_CCMPR.py]
2026-08-15 LELOTEMP_CCMPR: the mirror decides the edge, not the pin
    LELO_TEMP stacks two of these and mirrors the upper one MX, so the two
    TOP edges meet at the seam and the two BOTTOM edges become the pair's
    outer faces. So:
    VC shared between the halves -> top edge, and the two pads come
    out adjacent at the seam
    RST per-half (RST_A/RST_B upstairs) -> bottom, outer face
    CMPO per-half (CMPO_A/CMPO_B) -> bottom, outer face, even
    though its pin is 43 um up
    CMPO at the top would have put CMPO_A's pad inside the seam, where
    nothing above can reach it.
    VC's lane moved 248000 -> 264000: at 248000 it ran through
    IBP_1U<0>'s M1M2 via at y 356600..365400 (one short).
    0 DRC, shor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
    [LELOTEMP_CCMPR.py]
2026-08-15 LELOTEMP_CCMPR/LELO_TEMP: lift the seam pins, and delete three seam stories
    CCMPR: PWRUP_N_1V8 and PWRUP_B_1V8 stay mid-row -- the constraint is
    unchanged -- but they no longer stay on M1. The pin is 3200 x 4000 and
    every M1M2 cut is bigger than that in one direction: 1cuts,2vcuts
    overhangs 4400 in y, the default 2cuts,1vcuts overhangs 5200 in x, so
    the PARENT's via pad lands on the neighbouring device. Measured at the
    top: PWRUP_N's pad at (1081900,891600) touched REYATR_NCH_2C5F0's M1
    and PWRUP_B's the pmos next door -- two LVS shorts upstairs and
    nothing wrong down here. The cut is now made in this cell, which knows
    its own row, and the port is published on the M3 above it. This is
    what L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
    [LELOTEMP_CCMPR.py, LELO_TEMP.py]
2026-08-15 LELO_TEMP: bisect the shorts, 4 -> 1
    Found by taking routing AWAY. Two gates added for it and kept, because
    the next short will be found the same way: `_PHASES` names which of
    supplies/ibp/antenna/signals runs, and `_ONLY` names which signal
    stories are drawn. With both empty the tile still had 5 shorts, which
    said at once that none of them were in the top's own routes.
    What they were:
    1. THE MIRROR. Three were inside the mirrored upper comparator, all
    with `routes=none`, and all gone the moment the mirror came off.
    cicpy's rect collector placed a child by translation alone, so a
    mirrored block was read unmirrored. Fixed in cicpy (502d1f0) --
    shared repo, see that message.
    2.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
    [LELOTEMP_CCMPR.py, LELO_TEMP.py]
2026-08-15 LELO_TEMP: mirror the LOWER half, so the cap banks meet at the seam
    The pair mirrored its upper half, which put the two cap banks at the
    tile's extreme top and bottom, 100 um apart. They are the matched
    pair's matched element and they belong beside each other. Mirroring
    the LOWER half instead brings them together at the seam.
    The caps live at LELOTEMP_CCMPR's bottom, so this inverts which edge
    is which: the two BOTTOM edges now meet at the seam and the two TOP
    edges are the pair's outer faces. Every edge port swaps with it --
    VC shared -> bottom, and its two pads meet at the seam
    RST per-half -> top, the outer face
    CMPO per-half -> top, which is where its pin already was, so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
    [LELOTEMP_CCMPR.py, LELO_TEMP.py]
2026-08-15 LELO_TEMP: the VDD/VSS short was real, and it was a slide along a rail
    I called this one an artifact twice. It was not. netgen is the
    verdict and netgen said so plainly: extracted `Net: VSS` contained
    LELOTEMP_CCMPR/VDD_1V8, JNWTR_TAPCELLB_CV/AVDD, all thirteen
    JNWTR_PCHDL bulks and LELOTEMP_BIAS_IBP/VDD_1V8. The whole VDD
    network was in VSS.
    What misled me: checkroutes printed only VSS-to-VSS bridges for that
    component, and the top extracted 36 nets against the schematic's 24,
    which I read as fragmentation and therefore not merging. Both happen
    at once, and a net count says nothing about which.
    Bisected with LVS rather than checkroutes -- phase by phase, then
    block by block inside _suppli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
    [LELO_TEMP.py]
2026-08-15 LELO_TEMP: declare the crossing nets, and route three of them clean
    `_signals` is gone. Its four hundred lines of `beforeRoute` are now a
    `paths` table on the class, next to the `rows` they depend on, built by
    SidecarCell.routePaths (cicpy 83456ab). PWRUP_B stays a SEARCH -- a maze
    route takes a layer budget and two rects, not a story -- and is declared
    in `mazes` beside them so one gate covers both.
    `eband` moves to afterPlace with the other three channels: a channel is
    a fact about the placement, and a declaration cannot register one.
    ROUTED ONE NET AT A TIME, rebuilding and running checkroutes and DRC
    between each:
    () 0 shorts, 8 opens, DRC OK
    RST_A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
    [LELO_TEMP.py]
2026-08-15 feat(cmpr): the four columns route by declaration, not by search
    Every `wires` block in LELOTEMP_CMPR is gone -- 9 in the file and the
    1 that was never in it -- replaced by `paths` on the columns that own
    them. Needs the cicpy commit "declare a column's own routing".
    n_mirr_bias VSS -> blocked
    VBP2 -> trunk right_of_pins() on M1
    n_mirr_load VSS -> blocked
    VIP -> trunk right_of_pins() on M1
    VO -> trunk right_of_pins() on M1
    PWRUP_N -> trunk tab_lane() on M4, then taps
    VO1 -> a two-pin story: leave the drain east,
    up to M2,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
    [LELOTEMP_CMPR.py]
2026-08-15 feat(otar): the seven columns route by declaration, not by search
    Every `wires` block in LELOTEMP_OTAR is gone -- 7 blocks, 18 entries,
    7 wires_keys -- replaced by `paths` and `blocked` on the columns that
    own them. The top's `routes` are NOT converted yet; that is the next
    step and this cell is not done.
    p_in_a VDD_1V8 VIN -> trunk tab_lane() on M1
    VD1 -> trunk right_of_pins() on M1
    VS -> trunk left_of_pins() on M1
    p_in_b VD2 -> trunk right_of_pins() on M1
    VIP -> trunk tab_lane() on M1
    VS -> trunk left_of_pins() on M1
    VDD_1V8 -> blocked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
    [LELOTEMP_OTAR.py]
2026-08-15 feat(bias_ibp): the five columns route by declaration, not by search
    Every `wires` block in LELOTEMP_BIAS_IBP is gone -- 5 blocks, 17
    entries, 5 wires_keys -- replaced by `paths` and `blocked`. The top's
    `routes` are NOT converted; this cell is not done.
    r_lad R1<0..4> -> trunk tab_lane() on M1, one per rung, built
    from range(5): a rung added or removed
    changes the list and nothing else
    VSS -> blocked
    n_g VR1 -> blocked
    p_src LPI -> trunk tab_lane() on M1
    VDD_1V8 -> blocked (see below)
    VBD1 -> blocked, routed by the class's own hook
    p_cas VBD1 -> tru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
    [LELOTEMP_BIAS_IBP.py]
2026-08-15 fix(ccmpr): land IBP_1U<0> cutless on the core's own M4 stack
    Needs the cicpy commit "honour noendcut". klayout DRC on this cell was
    never run before today; it failed with 2 via2.1a, and the top with 4
    (two CCMPR instances). Magic reported 0 either way.
    The parent was dropping an M1 -> M4 stack on a pin where LELOTEMP_CMPR
    already has one. Matching the core's cut SHAPE had settled magic's
    hierarchy complaint, but the two stacks still sit 0.02 x 0.04 um apart
    and klayout, reading the flattened GDS, sees one notched polygon where
    a via must be a square.
    Moving them together is not available: measured at the site, the two
    stacks' viali and via1 rects coincide EXACTLY and only via2 differs, so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
    [LELOTEMP_CCMPR.py]
2026-08-15 fix(dig): the strip's ladder never ran -- rects() takes an instance
    The digital strip has had a hand-written ladder for its five internal
    nets. It has not run: `_bookRows` called
    sub.blockCell().rects(int(inst.x1), int(inst.y1))
    which is the RETIRED (dx, dy) signature. `rects()` takes the INSTANCE
    CHAIN now and composes each instance's own transform -- the only form
    that carries a mirror. Passed two ints it raised "'int' object is not
    reversible", the hook was caught, and the strip went unrouted; the
    maze router then failed on all 7 of its nets ("no path ... closest
    approach 30000 away") and the top carried 7 open nets that looked
    exactly like unfinished routing.
    Nothing about the lad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
    [LELO_TEMP.py]
2026-08-15 feat(top): stories for CMPO_A and CMPO_B, and the floor band they need
    Two of the four nets that had no story now have one, and the corridor
    they leave by is registered like every other band in this floorplan.
    `fband` -- the strip below the blocks, layout.y1 to the pair's y1.
    `cband` is the band ABOVE the pair and is what RST_A and PWRUP_N use;
    the nets published on the pair's BOTTOM edge had no corridor named at
    all, which is most of why they had no story. Measured before
    registering it (`blockers`, 1120000..1450000 by 0..16000): the only
    pin spans down there are VDD_1V8's own M1 ring bars at y 12000 and
    16000, so anything crossing on M3 or above clears them.
    THE LANES WERE ALREADY CHOSEN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
2026-08-15 docs(top): the pair's floor is VDD, and RST_B was misdiagnosed
    VSS declared as three M1 legs (gated off), and the measurement that
    explains both it and RST_B.
    M1 IS THE RIGHT LAYER FOR VSS. It is what the supply is in this
    library -- the rings are M1, every guard is M1, three of the five VSS
    pins are M1 bars -- so a leg that turns on it costs no plane and every
    guard it passes is another pin of itself. The gap it has to close is a
    floorplan fact: the bottom ring runs y 0..9000 and xbias publishes VSS
    at 15000..24000, so a supply ring and the block it rings never touch.
    THE LANE WAS WRONG, NOT THE LAYER. The pair's bottom nine microns are
    a VDD_1V8 guard, its full width -- LELOTEMP_CCMPR st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
    [LELO_TEMP.py]
2026-08-15 feat(top): VSS and RST_B closed -- opens 4 -> 2, still 0 DRC
    VSS, by measurement rather than by drawing. Three declared ring legs
    and a strip riser were written first and every one turned out to be a
    DUPLICATE: the supplies phase already lays a ring leg to xbias, both
    antenna diodes and the strip (its M4 riser at x 1478800 -- which also
    proves the strip's VSS column is ridable). Flooding the built .cic
    with the ring metal included showed the real splits:
    * the pair wrapper never joins its halves. beforePlace opens 2 um at
    the seam for capm.2a, so the two CCMPR VSS straps sit at y
    502000..511000 and 531000..540000 -- 20 um apart, joined by
    nothing, with a published pin floating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
2026-08-15 feat(top): every net closed -- make check is CLEAN
    LELO_TEMP shorts=0 opens=0
    magic drc 0, KDRC OK, antenna empty
    LVS: Circuits match uniquely -- first time ever
    make checkall: all five cells green on every check.
    The last two nets:
    PWRUP_N_1V8 -- its bias->pair story had no `end` step, on the claim
    that the pin's row east of it was the pair's own PWRUP_N on M5 and
    stopping there was landing on the net. Measured against the pair as
    built: nothing of this net is on M5 at that row; the leg flew over its
    own M3 pin two layers up. end() is the drop the claim stood in for.
    PWRUP_B_1V8 -- the one net still declared as a maze, and converting it
    is what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
    [LELO_TEMP.py]
2026-08-16 docs: plan for removing internal M5 (met4 stays only at the TT pin pads)
    Measured census of every M5 user at the top (8 nets, 13 ports, the
    strip's stub machinery), the TinyTapeout DEF constraint that reframes
    the goal -- tt_block_1x1_pg.def places every pin as LAYER met4, so the
    goal is NO INTERNAL M5, not no M5 -- four ordered phases each with its
    verification gate, and the two re-plan decisions (lband IBP legs,
    cband RST_A turn) the whole plan turns on.
    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
2026-08-16 fix(top): PWRUP_N crossed 6.6um ABOVE the TinyTapeout tile ceiling
    cband is 1040700..1063300 -- three legal tracks -- and the story said
    track 20, a stale index from a taller band that resolved to y ~1180000
    against the tile's 111.52 um. Every check passed, because no check
    knows the ceiling; assembling the tt_um top is what found it.
    Track 6: one lane above CMPO_B's crossing, clear of its riser. The
    tile's tallest metal is now 110.95 um. shorts=0 opens=0, magic drc 0,
    KDRC OK, LVS unique.
    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
    [LELO_TEMP.py]
2026-08-16 fix(top): retire the last stale cband indexes; the top band is empty
    cband is 1040700..1063300 -- three legal tracks -- and CMPO_B, RST_A
    and PWRUP_N still crossed on indexes 4, 8 and 6+20 from a taller band,
    drawing rows at up to 110.95 um. All in-tile after the ceiling fix,
    so every check passed; what they cost was the strip ABOVE the ring,
    which the tt_um assembly needs for its port fanout.
    CMPO_B -> 0, PWRUP_N -> 2 (met4 rows one lane apart), RST_A -> 2
    (met2/met3 beside them; its first try at 1 sat 0.1 um from the pair's
    own lifted pad and cost one met2.2).
    The tile above y 109.3 um now holds nothing but the M1 ring. shorts=0
    opens=0, magic drc 0, KDRC OK, LVS unique.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
    [LELO_TEMP.py]
2026-08-16 feat(tt): tt_um_lelo_temp_wulffern -- generated, DRC/KDRC/LVS clean
    The TinyTapeout wrapper, built the way the gr0x tiles taught and one
    step further: the whole .mag is GENERATED (gen_tt_um.py), never drawn.
    THE PORT ROW COMES FROM THE DEF. tt_block_1x1_pg.def is the authority
    (PLACED x, LAYER met4); the template .mag beside it is MIRRORED
    against it -- ena leftmost where the DEF has it rightmost -- which is
    the flip that was reported. gr01..04 each hand-corrected their copy;
    generating from the DEF removes the copy step that flipped it.
    The wrapper adds to the core: two west met4 power rails with one via
    stack each onto the core's own supply rings; ui_in[0] -> PWRUP_1V8
    (met4: top row, ea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
    [tt_um_lelo_temp_wulffern.sch]
2026-08-16 feat(supply): the tile's supply spine is metal, not locali
    The rings WERE the supply network, and they were locali: 0.9 x 154.5
    um per bar, 172 squares at ~12.8 ohm/sq = 2.2 kilo-ohm end to end --
    fed from the TT rails through one single-cut stack (~20 ohm: mcon 9.3
    + via1 4.5 + via2 3.4 + via3 3.4) per supply.
    Now:
    * both top rings carry a full-length met1 strap stitched with viali
    contact paint end to end (cicpy `straps=["M2"]`) -- ~100x lower,
    and legal HERE because nothing crosses the top's own ring rows on
    met1 (the top band was measured empty; the floor crossings ride
    met2/met3).
    * the tt_um rails land as WIDE stacks: metal pads over the whole
    rail-to-ring-row overlap with v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
2026-08-16 feat(tt): TinyTapeout precheck PASSES -- the core moves in from the edge
    `make precheck` now runs the full TT suite locally and every check is
    green: Magic DRC, KLayout, pin, boundary, power-pin, layer, cell-name,
    urpm/nwell, analog-pin, verilog.
    Two things stood between "does not work" and passing:
    * the tapeout/ submodule still carried the unedited TT template --
    top_module "tt_um_example" everywhere -- and precheck asserts the
    yaml's top_module against the gds name before it checks anything
    else. info.yaml and project.v now say what the design is.
    * the LEF exported VDPWR with an NWELL port. The core's guard nwell
    overhangs its own box by 0.44 um -- deliberately, it is the half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
    [gen_tt_um.py]
2026-08-16 docs(readme): 'How it works' and 'How to test', as the TT docs action requires
    tapeout/docs/info.md is generated from this README, and TinyTapeout's
    docs job checks it for exactly these two section titles. 'How' became
    'How it works'; 'How to test' states the protocol: power VDPWR, raise
    PWRUP_ANA (ui[0]), measure OSC_TEMP's (uo[0]) frequency, sweep
    temperature to calibrate.
    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
2026-08-16 docs: layout flow lives with cicpy now
    The 363-line copy drifts; the flow is documented once, with the tool
    that implements it: analogicus.com/cicpy/agent_layout.html. This page
    keeps the pointer, the build commands, and names the two reference
    cells in this repository the guide leans on.
    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
2026-08-16 sim(tt): function bench for the wrapper, both views passing
    Does the tile work THROUGH the TinyTapeout pins: VDPWR up, PWRUP_ANA
    on ui_in[0], oscillator on uo_out[0]. Measured (Gt Ktt Tt Vt):
    -40C 25C Lay/Sch @25C
    Sch 1.70 MHz 2.42 MHz
    Lay 1.40 MHz 1.99 MHz -18% (full-RC extraction)
    idd ~61 uA ~84 uA running
    iddq 4-11 nA powered down through the wrapper
    uio_oe 0 V on both ends of the bus (tie-lows hold)
    Three traps, each now handled where the next bench will find it:
    * xschem netlists the tree with <> buses while the TT ports are [] --
    the bench's netlist step maps only the five TT pref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
2026-08-16 sim(LELO_TEMP): re-run Sch and Lay, refresh results and README plots
    Full Sch suite (calibrate typical/process/mc, tran typical + 18
    corners + 10x MC) and both Lay runs (typical, supply) re-run against
    today's layout -- the strapped rings, the completed top routing and
    the antenna diodes, none of which the old results had seen. The three
    plots the top README embeds are regenerated from the fresh runs; the
    per-run tables live in sim/LELO_TEMP/README.md (results/ artifacts
    stay local by the repo's ignore policy).
    THE LAY RUNS NEEDED THEIR OWN CALIBRATION. tran.py pairs a tran run
    with the calibrate run of the SAME view, and only Sch calibration had
    been refreshed: the fresh Lay tran against t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
2026-08-16 sim(LELO_TEMP): Lay etc and mc runs, one figure per run-set
    The extracted netlist now runs the same sets as the schematic:
    typical, etc (18 corners) and mc (10 samples), calibrated per process
    corner at Vt. plot_results.py replaces the per-run rainbow plots with
    one figure per set -- Sch and Lay as rows, one- and two-point
    calibration as columns, points colored blue-to-red by temperature,
    industrial spec as dashed lines, commercial as the dotted box, worst
    error printed per panel. Measured: Lay one-point over the full etc
    matrix is outside the +/-15 C industrial spec at +19.2/-17.9 C
    (two-point holds at +7.7/-2.3 C); the summary table flags it.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
2026-08-16 plot: black lines, the temperature colors were hard to read
    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
2026-08-16 layout: solid supply ties, width is now a design decision
    The five ring ties were rule-width threads. Now: both bias bars tie
    to their rings with 90 um of M1 across the full gap, the strip's two
    M4 risers are 1.8 um (2.0 sat 0.22 um off RST_B's leg, met3.2), and
    the VSS seam leg down lband is 1.0 um, one pitch further into the
    band (at +SPACE its edge sat 0.03 um off the bias block's li, 4x
    li.3). checkall green: DRC/KDRC 0 on every cell, all five LVS
    'Circuits match uniquely', ANT 0; wrapper DRC 0 and LVS match.
    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
2026-08-16 layout: subcell rings strapped met1, gaps where the rows are owned
    Every ring in the hierarchy now carries the met1-over-locali strap:
    BIAS_IBP full length (rows measured clear), OTAR VDD full / VSS
    gapped, CCMPR and CMPR gapped on both rows. Gaps are measured from
    the built tile: terminating pads get 0.2 um, through-descents 0.6 um
    (the via pad is wider than its wire, and with 0.2 the top's PWRUP
    corridor no longer fit its own freeColumns column), and the CCMPR
    VDD strap yields the span under the top's 17.4 um feed stack (two
    cells' contact paint may not partially overlap). OTAR's gaps are
    measured where it LIVES (inside BIAS_IBP) -- standalone missed the
    VCP/VD1/VR1 descents and merged VCP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
    [LELOTEMP_BIAS_IBP.py, LELOTEMP_CCMPR.py, LELOTEMP_CMPR.py, LELOTEMP_OTAR.py]
2026-08-16 layout: the pair's ground is a plate, its VDD three ways stronger
    The halves' VSS rows sat 2 um apart at the seam joined by ONE
    rule-width vertical; a locali+met1 plate now fills the whole seam
    sandwich. The VDD join between the halves' rings goes 3000 -> 6000
    (the neighbouring free columns sit past the row straps' gap edges,
    so one wider wire, not more columns), and a 5 um locali+met1 tie
    drops from the top ring straight onto the upper comparator's own
    VDD row.
    No coordinate tables: the plate and tie measure what is already
    drawn (blockedSpans walks rects, paths, ports and contact cells;
    childRingStrapGaps reads the spans the halves' own straps leave
    open, which carry the crossings only a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
2026-08-16 model: the comparator delay was capacitance -- fit C per view
    dt regresses to < 1 ns over -40..125 C as C*(Vc/I) + delay with
    delay ~ 0. The hand C (291 fF) was 28 fF short of even the
    schematic; extraction adds ~66 fF more, nearly all of it wiring on
    IBP_1U<0>/<2> -- the timing caps hang directly on the PTAT
    distribution net, which crosses the whole tile. LELO_TEMP.FIT now
    carries the fitted (C, delay) per netlist view and the
    post-processing picks the view from the run name.
    One-point calibration falls from +11.2/-8.2 C to about +/-1 C
    typical, etc corners 19 -> 9.7/-7.0; every accuracy spec passes
    except the mc 1-pt tail (-16.08 vs -15; 2-pt passes everywhere).
    Also the RC extraction as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
    [LELO_TEMP.py]
2026-08-17 docs: dead links replaced, stale tables refreshed
    The Diodes link and the aic2026 project link pointed at dated URLs
    the site no longer serves (both 404, measured); they now point at
    the slug pages. model.ipynb was referenced twice and does not
    exist -- the tables come from py/LELO_TEMP.py, which is what they
    cite now, by absolute URL so the generated schematic page works
    too. The frequency table carried the old hand C (291 fF): the
    calibrated extracted-view model says 1.399/1.994/3.185 MHz at
    -40/25/125 C, which is also what the Lay simulation measures. The
    README paragraph blaming the Lay one-point error on a
    schematic-only calibration described the model before FIT existed.
    Co-Authored-B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
2026-08-17 docs: the schematic pages describe the cells the design actually uses
    The published doc still carried LELOTEMP_CCMP and LELOTEMP_CMP,
    which the schematic no longer instantiates -- LELO_TEMP.sch holds
    only CCMPR/CMPR/OTAR. New pages for both current cells (verified
    against the netlist: five MIM units on IBP_1U<0>, the RST discharge
    NMOS and the PWRUP_N holddown live in CMPR as xg1/xg4, the block
    table kept but attributed to the predecessor bench, the tile-level
    fitted C added), and info.yaml's doc list follows. Also the cell
    name typo in LELO_TEMP.md (LEOTEMP_BIAS_IPB), the stale-generation
    CCMP references, and three spelling slips (temperaturw, Aweep,
    lmits).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
2026-08-17 docs: key parameters report measured performance; CCMPR sticks to what is
    The key parameter table carried the target spec; it now carries what
    the extracted view measures -- frequency 1.1/2.0/4.0 MHz, supply
    current 63/83/107 uA, power-down 10/11/50 nA, temperature error
    -6.7..+9.1 C (1-pt) and -7.3..+5.3 C (2-pt) -- with a note saying
    what Typ and Min/Max span. The CCMPR and CMPR pages drop the
    predecessor lineage and the predecessor-bench table; the fitted
    effective capacitance from the current top-level runs stands alone.
    Claude-Session: https://claude.ai/code/session_01Cs4HEXfVhxqxn3EPo77kKw
2026-08-17 docs: key parameters over the commercial range, and say so
    Frequency 1.4/2.0/3.2 MHz and temperature error -3.7..+2.9 C
    (1-point) / -1.9..+1.5 C (2-point) over 0..70 C across the extreme
    test condition corners, with the industrial-range numbers kept as a
    sentence below the table.
    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
2026-08-17 docs: key parameters over the full industrial range
    Frequency 1.1/2.0/4.0 MHz and temperature error -6.7..+9.1 C
    (1-point) / -7.3..+5.3 C (2-point) over -40..125 C across the
    extreme test condition corners; the commercial-range error stays as
    a sentence below the table.
    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
2026-08-17 model: say why the fitted delay is negative
    The second FIT term is a regression intercept, not the physical
    comparator delay: a PTAT-starved comparator's delay scales ~1/I,
    the same temperature shape as the Vc/I basis, so the real (positive,
    few ns) delay folds into C_eff. The intercept holds the ramp's head
    start from reset charge injection and the absolute error of the
    analytic Vc and the R table -- small constant-ish terms of either
    sign.
    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
    [LELO_TEMP.py]
2026-08-17 sch(bias_ibp): dangling wires out, startup pair where it reads
    The fill area carried 68 wire stubs at 17 positions left over from
    before the dummies became vector instances -- nothing touched them.
    The startup pmos pair hung mid-schematic off two 370-unit VDD
    verticals; it now sits directly under the rail with one clean VD1
    drop down the left side. The regenerated netlist is byte-identical.
    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
    [LELOTEMP_BIAS_IBP.sch]
2026-08-17 sch(bias_ibp): the fill dummies sit beside the core
    They lived 1500 units east and 2000 above anything else, so the
    schematic never fit one view; both vector instances now sit in the
    right margin next to the dummy mirror device. Netlist byte-identical
    and LVS run to be sure: Circuits match uniquely.
    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
    [LELOTEMP_BIAS_IBP.sch]
